TorstenRobitzki/DevPort/hardware/components/Diode_Wurth%20Electronics%20Inc_8240116/eec.models/Wurth_Electronics_Inc_-_8240116.step

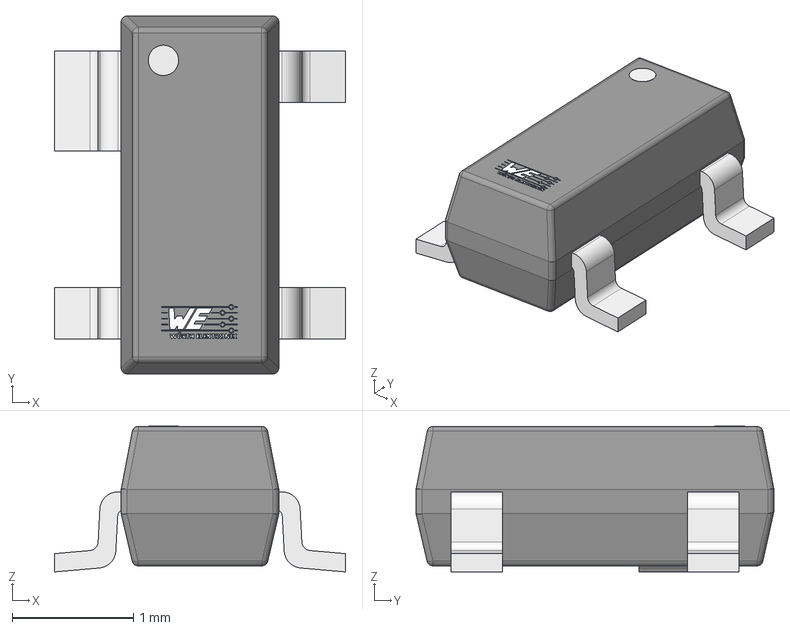
[picture p1: CAD file, 2021-03-17]
hardware/components/Diode_Wurth%20Electronics%20Inc_8240116/eec.models/Wurth_Electronics_Inc_-_8240116.step
2.40 x 2.95 x 1.20 mm
IC_BODY
IC_LEG
circle
IC_LEG_1 x 3
Wurth Electronik
