TorstenRobitzki/DevPort/hardware/components/Trans_On_Semiconductor_MCH3478-TL-H/eec.models/On_Semiconductor_-_MCH3478-TL-H.step

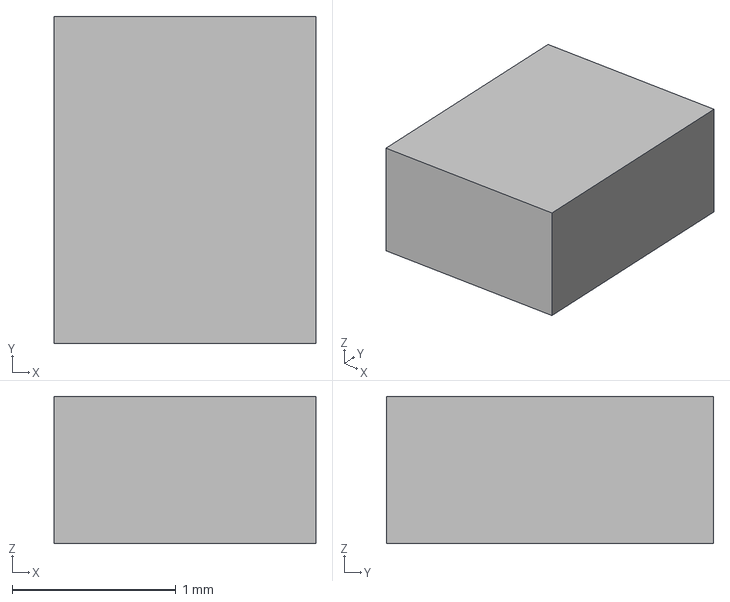
[picture p2: CAD file, 2021-03-17]
hardware/components/Trans_On_Semiconductor_MCH3478-TL-H/eec.models/On_Semiconductor_-_MCH3478-TL-H.step
1.60 x 2.00 x 0.9 mm
