TorstenRobitzki/DevPort/hardware/components/TUSB8041RGCR/TUSB8041RGCR.step

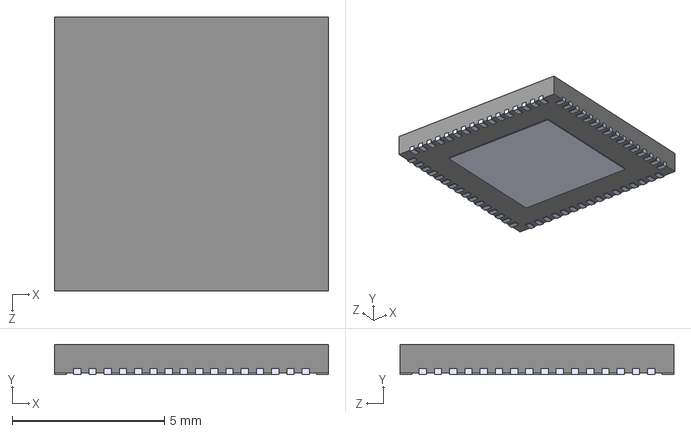
[picture p3: CAD file, 2021-03-17]
hardware/components/TUSB8041RGCR/TUSB8041RGCR.step
9.00 x 1.00 x 9.00 mm
