TorstenRobitzki/DevPort/hardware/lichtleiter.FCStd

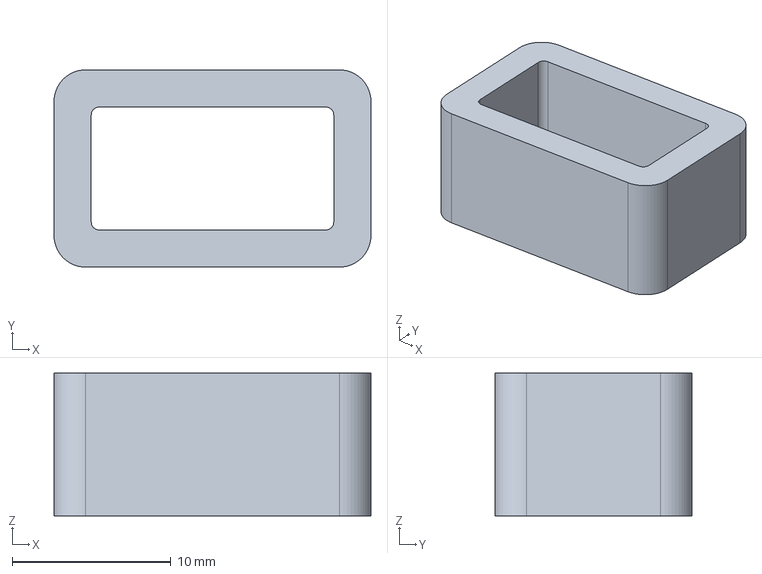
[picture p4: CAD file, 2021-03-17]
hardware/lichtleiter.FCStd
20.0 x 12.4 x 9.00 mm
