TorstenRobitzki/DevPort/hardware/todo.txt

- 1,6mm Platinendicke, wegen USB Stecker
- Passen alle Komponenten am I2C Bus zusammen?
- "It is recommended that only one board ground plane be used in the design." (8041A)
