TorstenRobitzki/DevPort/hardware/base-plane/base-plane.kicad_pcb

## KiCad design hardware/base-plane/base-plane.kicad_pcb (2021-06-17)

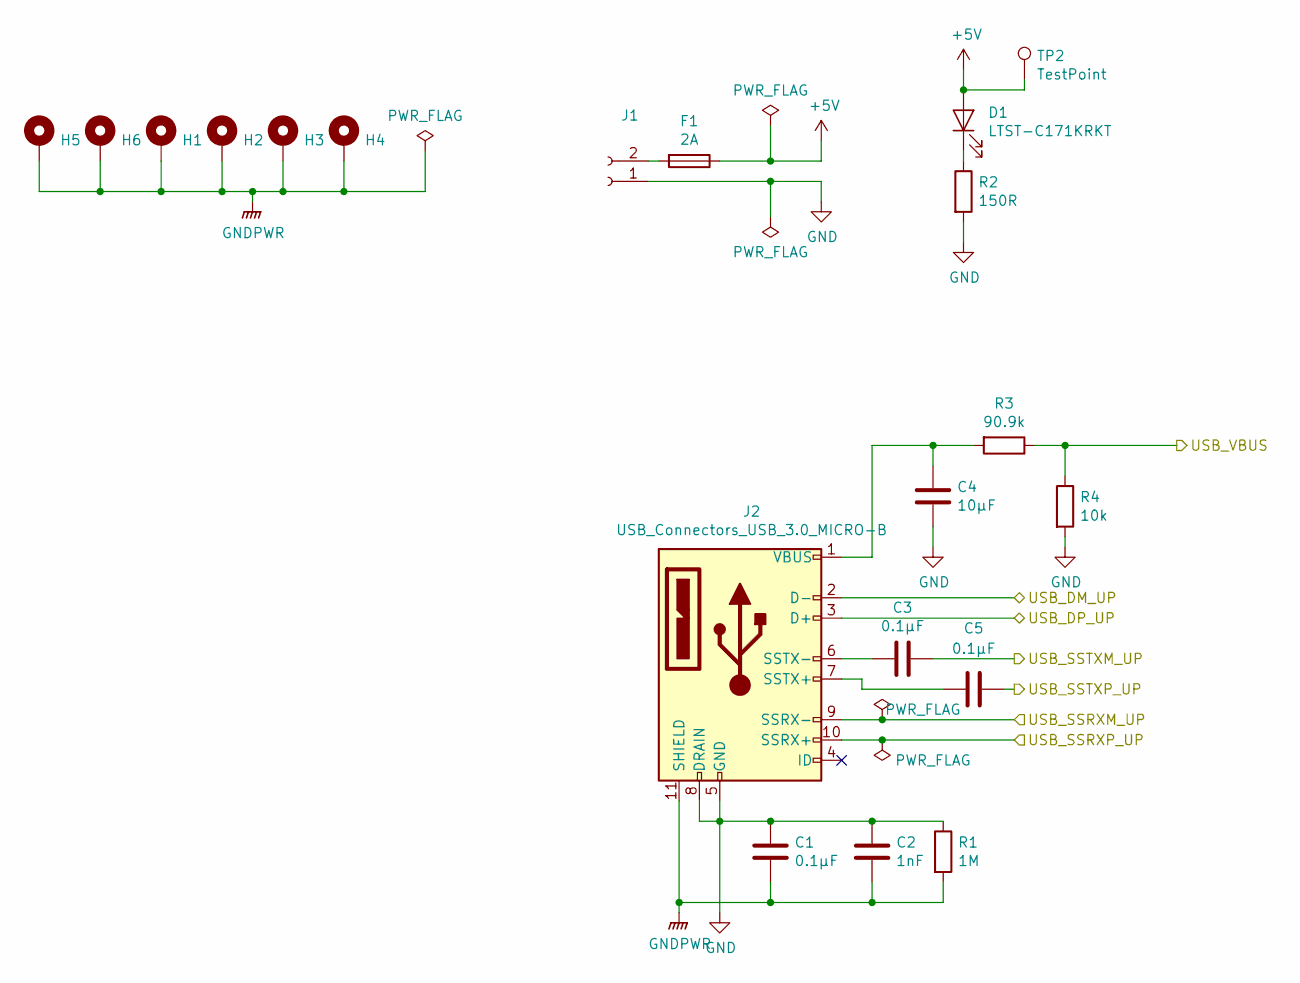
[picture p5: schematic inputs.sch, DevPort Base-Plane]

Parts:
C1, C3, C5: 0.1µF; C_0603_1608Metric
C2: 1nF; C_0603_1608Metric
C4: 10µF; C_0603_1608Metric
D1: LTST-C171KRKT; LED_0805_2012Metric
F1: 2A; Fuse_0603_1608Metric
H1, H2, H3, H4, H5, H6: MountingHole_Pad; MountingHole_3.2mm_M3_Pad_Via
J1: Conn_01x02_Female; Molex_Mini-Fit_Jr_5566-02A_2x01_P4.20mm_Vertical
J2: USB_Connectors_USB_3.0_MICRO-B; 692622420101
R1: 1M; R_0603_1608Metric
R2: 150R; R_0603_1608Metric
R3: 90.9k; R_0603_1608Metric
R4: 10k; R_0603_1608Metric
TP2: TestPoint; TestPoint_THTPad_1.0x1.0mm_Drill0.5mm

Connections:
+5V: D1.2 (A), F1.1, TP2.1; also elsewhere on the board
/hub/USB_DM_UP: J2.2 (D-); also elsewhere on the board
/hub/USB_DP_UP: J2.3 (D+); also elsewhere on the board
/hub/USB_SSRXM_UP: J2.9 (SSRX-); also elsewhere on the board
/hub/USB_SSRXP_UP: J2.10 (SSRX+); also elsewhere on the board
/hub/USB_SSTXM_UP: C3.1; also elsewhere on the board
/hub/USB_SSTXP_UP: C5.1; also elsewhere on the board
/hub/USB_VBUS: R3.1, R4.1; also elsewhere on the board
GND: C1.1, C2.1, C4.1, J1.1, J2.5 (GND), J2.8 (DRAIN), R1.1, R2.2, R4.2; also elsewhere on the board
GNDPWR: C1.2, C2.2, H1.1, H2.1, H3.1, H4.1, H5.1, H6.1, J2.11 (SHIELD), R1.2; also elsewhere on the board
unnamed: C3.2, J2.6 (SSTX-)
unnamed: C4.2, J2.1 (VBUS), R3.2
unnamed: C5.2, J2.7 (SSTX+)
unnamed: D1.1 (K), R2.1
unnamed: F1.2, J1.2

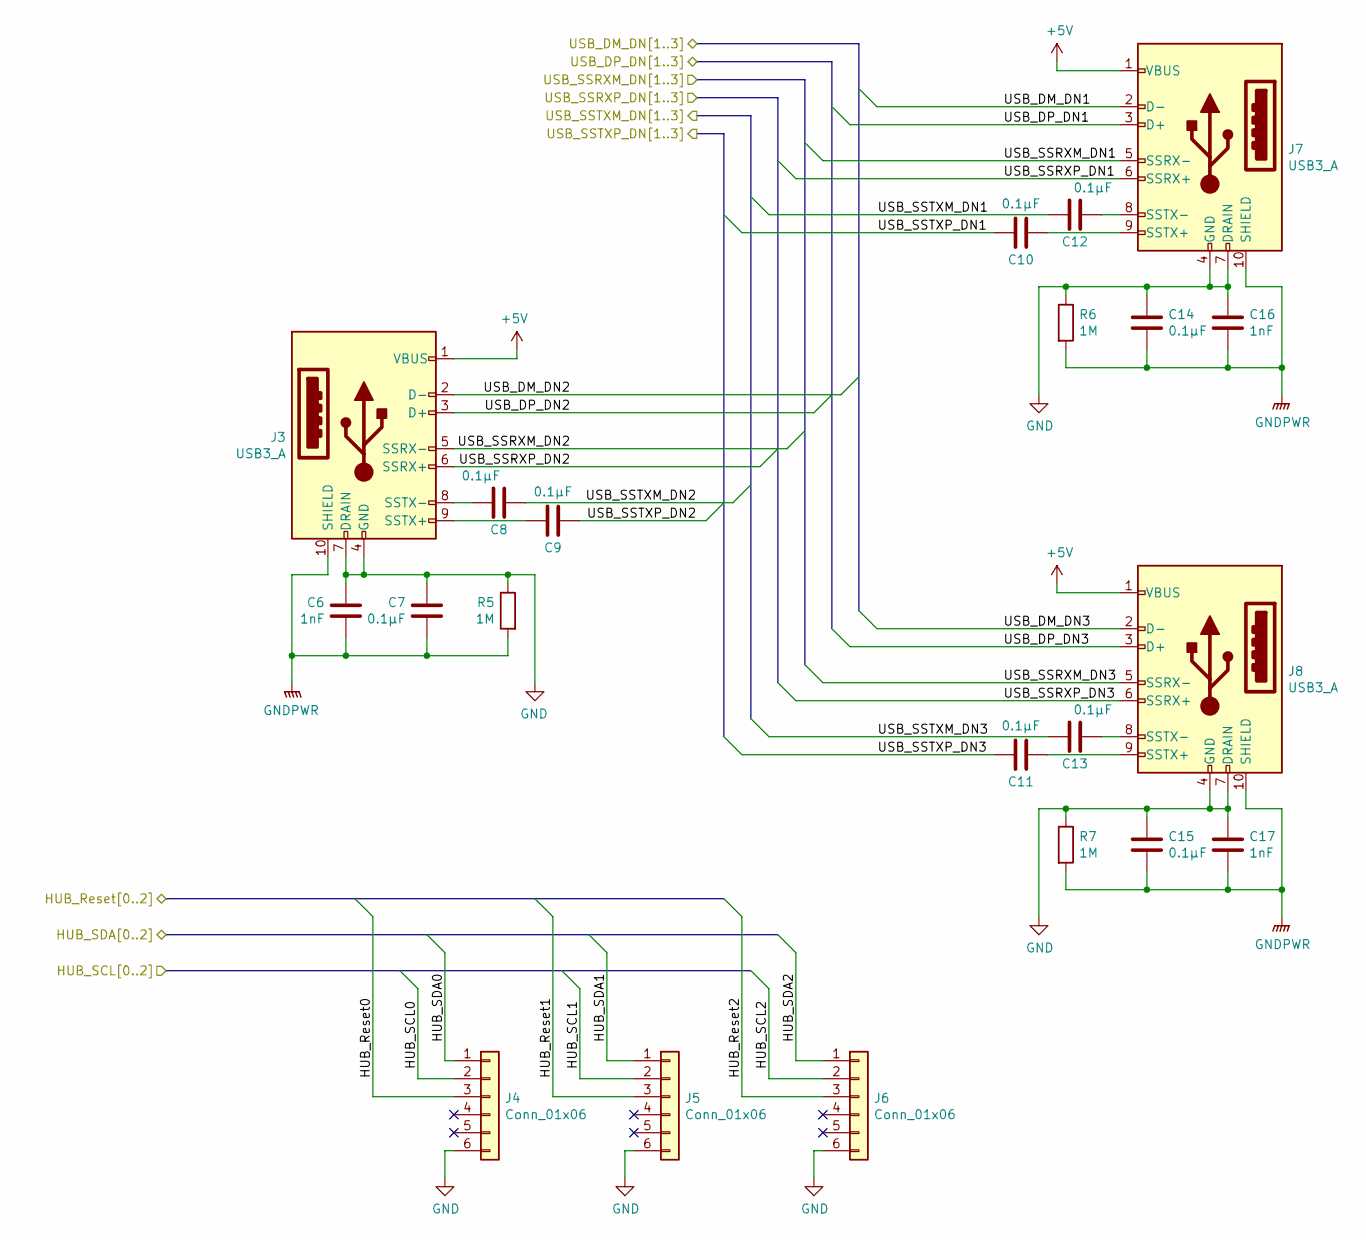
[picture p6: schematic outputs.sch, DevPort Base-Plane]

Parts:
C6, C16, C17: 1nF; C_0603_1608Metric
C7, C8, C9, C10, C11, C12, C13, C14, C15: 0.1µF; C_0603_1608Metric
J3, J7, J8: USB3_A; LUSB-3593-00
J4, J5, J6: Conn_01x06; PinHeader_2x03_P1.27mm_Vertical_SMD
R5, R6, R7: 1M; R_0603_1608Metric

Connections:
+5V: J3.1 (VBUS), J7.1 (VBUS), J8.1 (VBUS); also elsewhere on the board
/controller/HUB_Reset0: J4.3; also elsewhere on the board
/controller/HUB_Reset1: J5.3; also elsewhere on the board
/controller/HUB_Reset2: J6.3; also elsewhere on the board
/controller/HUB_SCL0: J4.2; also elsewhere on the board
/controller/HUB_SCL1: J5.2; also elsewhere on the board
/controller/HUB_SCL2: J6.2; also elsewhere on the board
/controller/HUB_SDA0: J4.1; also elsewhere on the board
/controller/HUB_SDA1: J5.1; also elsewhere on the board
/controller/HUB_SDA2: J6.1; also elsewhere on the board
/hub/USB_DM_DN1: J7.2 (D-); also elsewhere on the board
/hub/USB_DM_DN2: J3.2 (D-); also elsewhere on the board
/hub/USB_DM_DN3: J8.2 (D-); also elsewhere on the board
/hub/USB_DP_DN1: J7.3 (D+); also elsewhere on the board
/hub/USB_DP_DN2: J3.3 (D+); also elsewhere on the board
/hub/USB_DP_DN3: J8.3 (D+); also elsewhere on the board
/hub/USB_SSRXM_DN1: J7.5 (SSRX-); also elsewhere on the board
/hub/USB_SSRXM_DN2: J3.5 (SSRX-); also elsewhere on the board
/hub/USB_SSRXM_DN3: J8.5 (SSRX-); also elsewhere on the board
/hub/USB_SSRXP_DN1: J7.6 (SSRX+); also elsewhere on the board
/hub/USB_SSRXP_DN2: J3.6 (SSRX+); also elsewhere on the board
/hub/USB_SSRXP_DN3: J8.6 (SSRX+); also elsewhere on the board
/hub/USB_SSTXM_DN1: C12.2; also elsewhere on the board
/hub/USB_SSTXM_DN2: C8.2; also elsewhere on the board
/hub/USB_SSTXM_DN3: C13.2; also elsewhere on the board
/hub/USB_SSTXP_DN1: C10.2; also elsewhere on the board
/hub/USB_SSTXP_DN2: C9.2; also elsewhere on the board
/hub/USB_SSTXP_DN3: C11.2; also elsewhere on the board
GND: C6.1, C7.1, C14.1, C15.1, C16.1, C17.1, J3.4 (GND), J3.7 (DRAIN), J4.6, J5.6, J6.6, J7.4 (GND), J7.7 (DRAIN), J8.4 (GND), J8.7 (DRAIN), R5.1, R6.1, R7.1; also elsewhere on the board
GNDPWR: C6.2, C7.2, C14.2, C15.2, C16.2, C17.2, J3.10 (SHIELD), J7.10 (SHIELD), J8.10 (SHIELD), R5.2, R6.2, R7.2; also elsewhere on the board
unnamed: C8.1, J3.8 (SSTX-)
unnamed: C9.1, J3.9 (SSTX+)
unnamed: C10.1, J7.9 (SSTX+)
unnamed: C11.1, J8.9 (SSTX+)
unnamed: C12.1, J7.8 (SSTX-)
unnamed: C13.1, J8.8 (SSTX-)

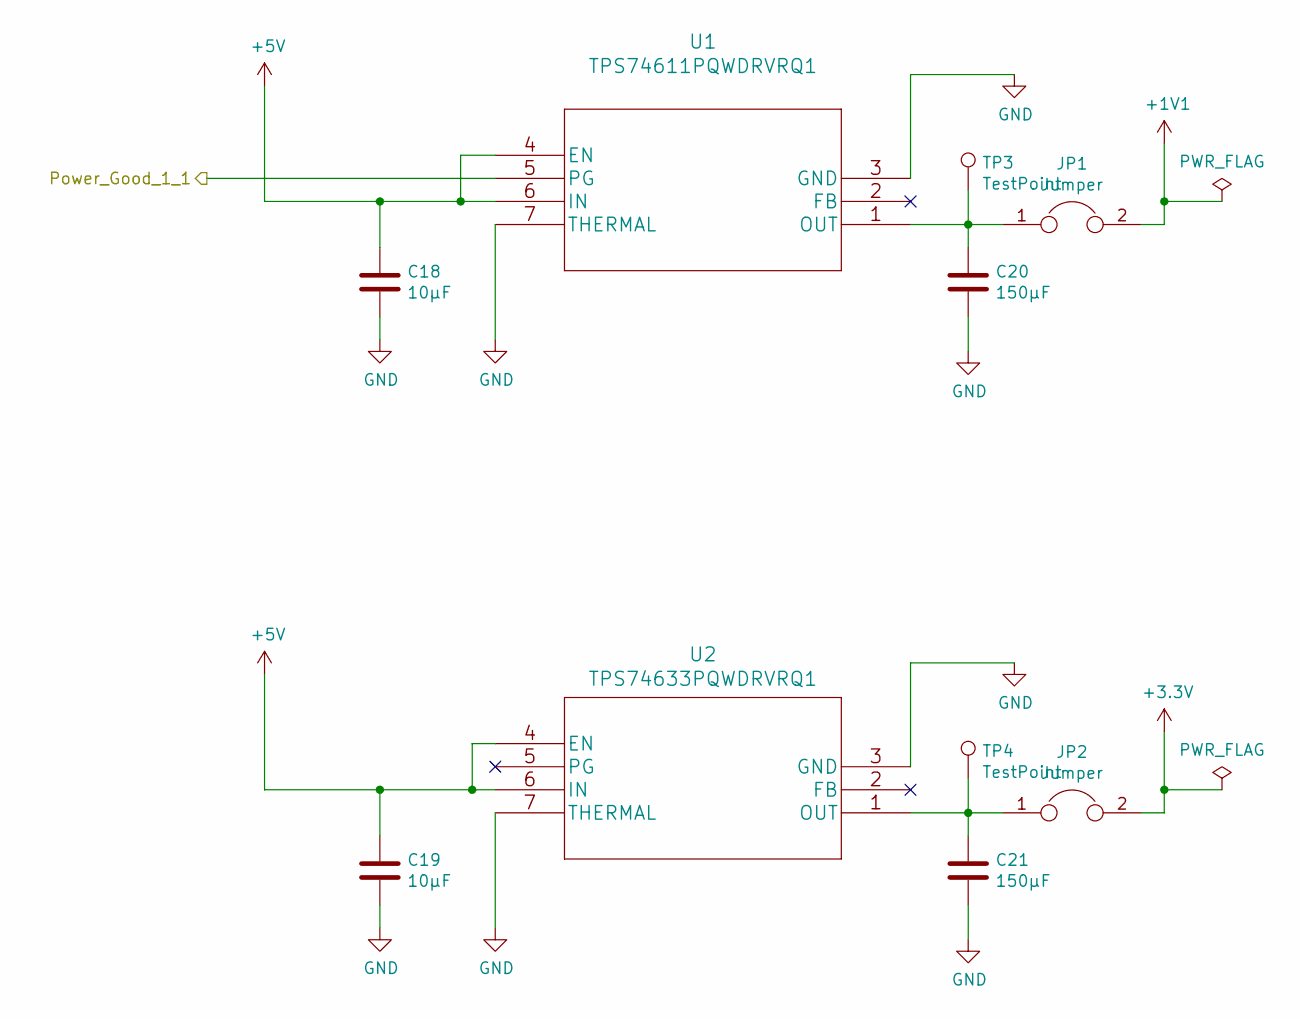
[picture p7: schematic power.sch, DevPort Base-Plane]

Parts:
C18, C19: 10µF; C_0603_1608Metric
C20, C21: 150µF; C_1210_3225Metric
JP1, JP2: Jumper; SolderJumper-2_P1.3mm_Bridged_RoundedPad1.0x1.5mm
TP3, TP4: TestPoint; TestPoint_THTPad_1.0x1.0mm_Drill0.5mm
U1: TPS74611PQWDRVRQ1; TPS74601PBQWDRVRQ1
U2: TPS74633PQWDRVRQ1; TPS74601PBQWDRVRQ1

Connections:
+1V1: JP1.2; also elsewhere on the board
+5V: C18.1, C19.1, U1.4 (EN), U1.6 (IN), U2.4 (EN), U2.6 (IN); also elsewhere on the board
/controller/Power_Good_1_1: U1.5 (PG); also elsewhere on the board
GND: C18.2, C19.2, C20.2, C21.2, U1.3 (GND), U1.7 (THERMAL), U2.3 (GND), U2.7 (THERMAL); also elsewhere on the board
unnamed: C20.1, JP1.1, TP3.1, U1.1 (OUT)
unnamed: C21.1, JP2.1, TP4.1, U2.1 (OUT)

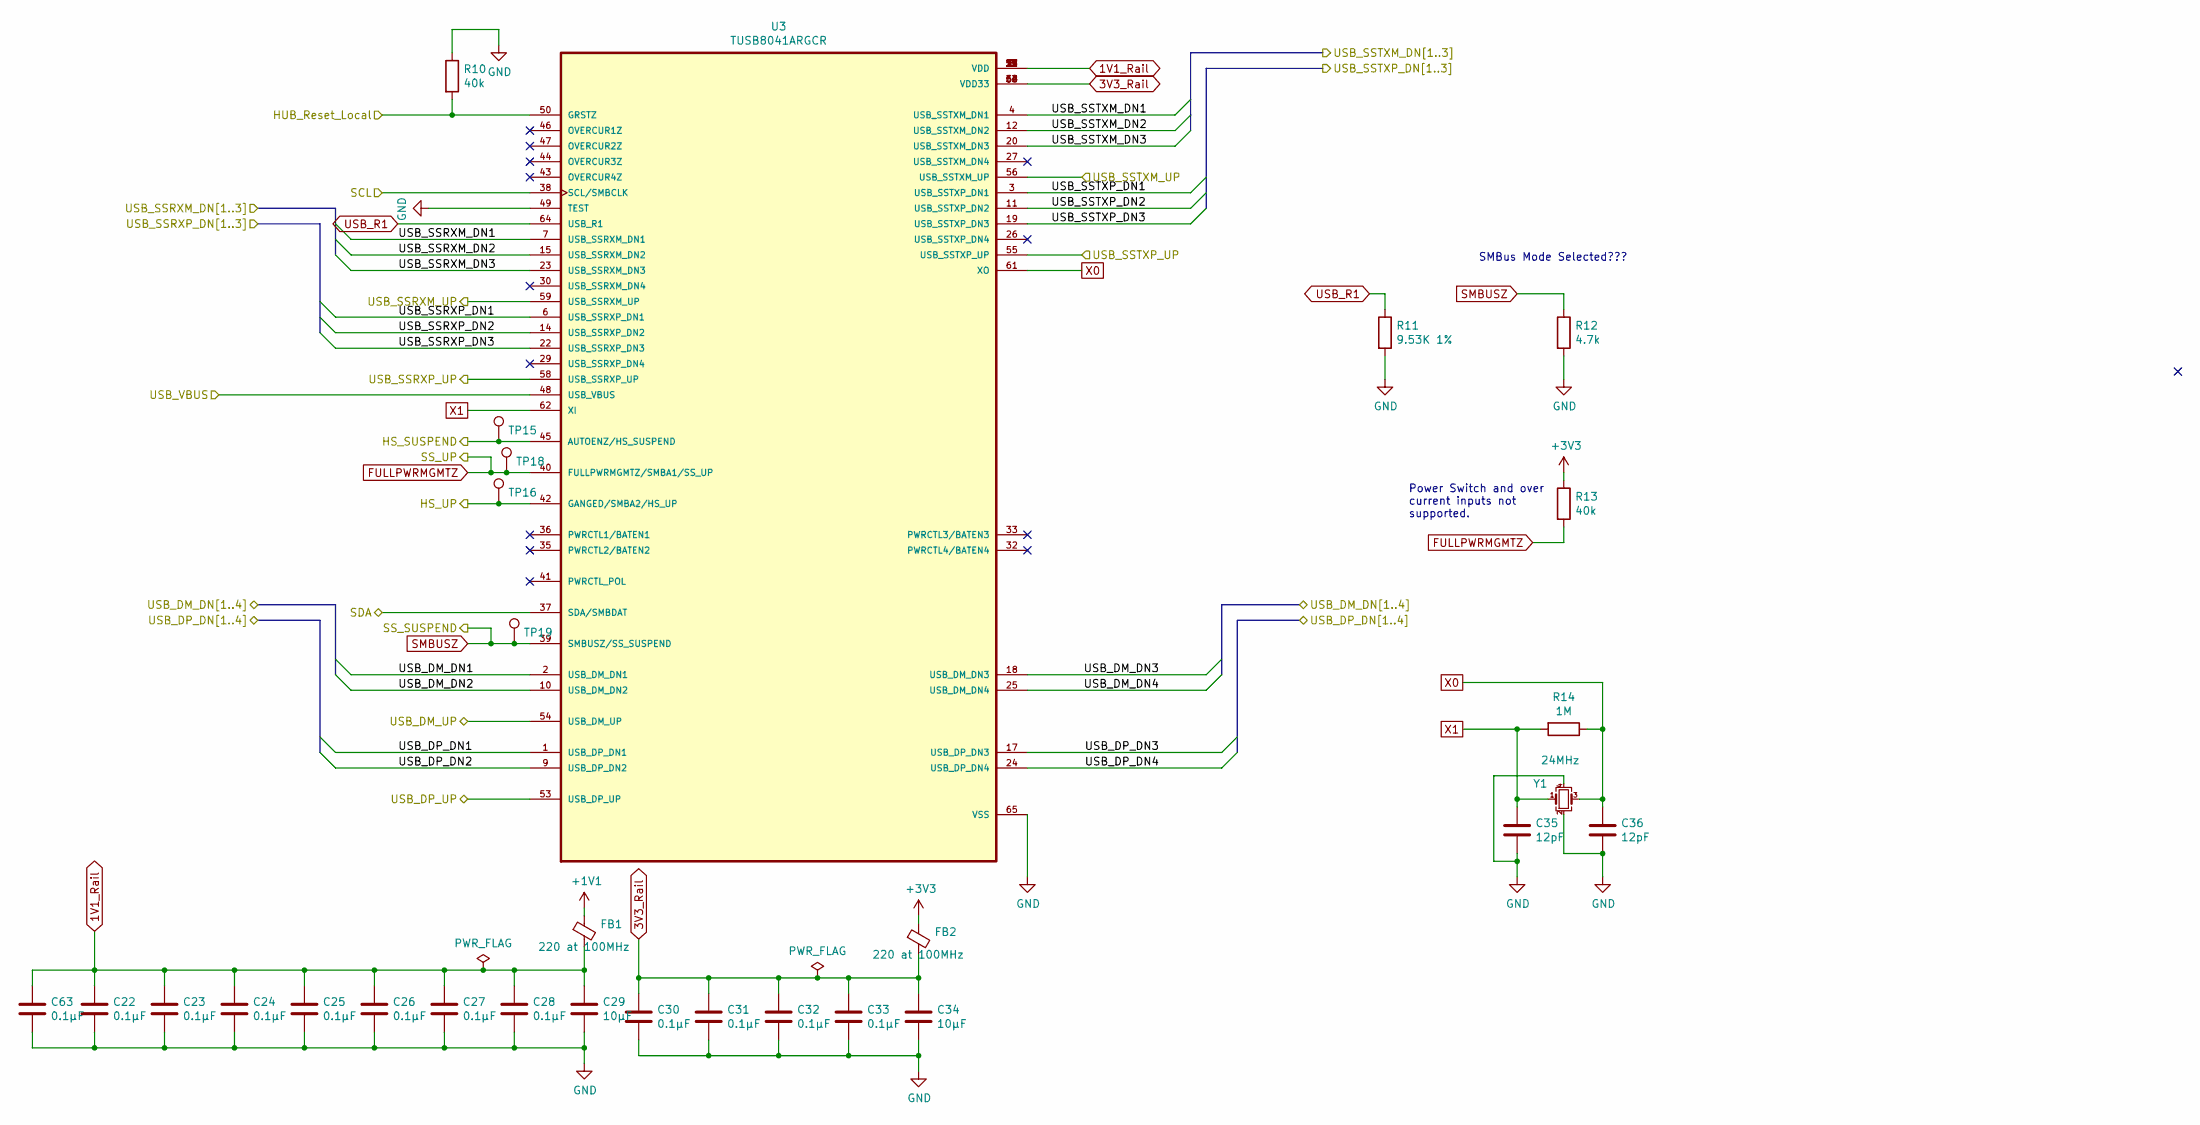
[picture p8: schematic hub.sch, DevPort Base-Plane]

Parts:
C22, C23, C24, C25, C26, C27, C28, C30, C31, C32, C33, C63: 0.1µF; C_0603_1608Metric
C29, C34: 10µF; C_0603_1608Metric
C35, C36: 12pF; C_0603_1608Metric
FB1, FB2: 220 at 100MHz; L_0603_1608Metric
R10, R13: 40k; R_0603_1608Metric
R11: 9.53K 1%; R_0603_1608Metric
R12: 4.7k; R_0603_1608Metric
R14: 1M; R_0603_1608Metric
TP15, TP16, TP18, TP19: TestPoint; TestPoint_THTPad_1.0x1.0mm_Drill0.5mm
U3: TUSB8041ARGCR; QFN50P900X900X100-65N
Y1: 24MHz; Crystal_SMD_3225-4Pin_3.2x2.5mm

Connections:
1V1_Rail: C22.1, C23.1, C24.1, C25.1, C26.1, C27.1, C28.1, C29.1, C63.1, FB1.2, U3.5 (VDD), U3.8 (VDD), U3.13 (VDD), U3.21 (VDD), U3.28 (VDD), U3.31 (VDD), U3.51 (VDD), U3.57 (VDD)
3V3_Rail: C30.1, C31.1, C32.1, C33.1, C34.1, FB2.2, U3.16 (VDD33), U3.34 (VDD33), U3.52 (VDD33), U3.63 (VDD33)
+1V1: FB1.1; also elsewhere on the board
/hub/USB_DM_DN1: U3.2 (USB_DM_DN1); also elsewhere on the board
/hub/USB_DM_DN2: U3.10 (USB_DM_DN2); also elsewhere on the board
/hub/USB_DM_DN3: U3.18 (USB_DM_DN3); also elsewhere on the board
/hub/USB_DM_UP: U3.54 (USB_DM_UP); also elsewhere on the board
/hub/USB_DP_DN1: U3.1 (USB_DP_DN1); also elsewhere on the board
/hub/USB_DP_DN2: U3.9 (USB_DP_DN2); also elsewhere on the board
/hub/USB_DP_DN3: U3.17 (USB_DP_DN3); also elsewhere on the board
/hub/USB_DP_UP: U3.53 (USB_DP_UP); also elsewhere on the board
/hub/USB_SSRXM_DN1: U3.7 (USB_SSRXM_DN1); also elsewhere on the board
/hub/USB_SSRXM_DN2: U3.15 (USB_SSRXM_DN2); also elsewhere on the board
/hub/USB_SSRXM_DN3: U3.23 (USB_SSRXM_DN3); also elsewhere on the board
/hub/USB_SSRXM_UP: U3.59 (USB_SSRXM_UP); also elsewhere on the board
/hub/USB_SSRXP_DN1: U3.6 (USB_SSRXP_DN1); also elsewhere on the board
/hub/USB_SSRXP_DN2: U3.14 (USB_SSRXP_DN2); also elsewhere on the board
/hub/USB_SSRXP_DN3: U3.22 (USB_SSRXP_DN3); also elsewhere on the board
/hub/USB_SSRXP_UP: U3.58 (USB_SSRXP_UP); also elsewhere on the board
/hub/USB_SSTXM_DN1: U3.4 (USB_SSTXM_DN1); also elsewhere on the board
/hub/USB_SSTXM_DN2: U3.12 (USB_SSTXM_DN2); also elsewhere on the board
/hub/USB_SSTXM_DN3: U3.20 (USB_SSTXM_DN3); also elsewhere on the board
/hub/USB_SSTXM_UP: U3.56 (USB_SSTXM_UP); also elsewhere on the board
/hub/USB_SSTXP_DN1: U3.3 (USB_SSTXP_DN1); also elsewhere on the board
/hub/USB_SSTXP_DN2: U3.11 (USB_SSTXP_DN2); also elsewhere on the board
/hub/USB_SSTXP_DN3: U3.19 (USB_SSTXP_DN3); also elsewhere on the board
/hub/USB_SSTXP_UP: U3.55 (USB_SSTXP_UP); also elsewhere on the board
FULLPWRMGMTZ: R13.2, TP18.1, U3.40 (FULLPWRMGMTZ/SMBA1/SS_UP); also elsewhere on the board
GND: C22.2, C23.2, C24.2, C25.2, C26.2, C27.2, C28.2, C29.2, C30.2, C31.2, C32.2, C33.2, C34.2, C35.2, C36.2, C63.2, R10.1, R11.2, R12.2, U3.49 (TEST), U3.65 (VSS), Y1.2, Y1.4; also elsewhere on the board
HS_SUSPEND: TP15.1, U3.45 (AUTOENZ/HS_SUSPEND); also elsewhere on the board
HS_UP: TP16.1, U3.42 (GANGED/SMBA2/HS_UP); also elsewhere on the board
HUB_Reset_Local: R10.2, U3.50 (GRSTZ); also elsewhere on the board
unnamed 105: U3.48 (USB_VBUS); also elsewhere on the board
SCL: U3.38 (SCL/SMBCLK); also elsewhere on the board
SDA: U3.37 (SDA/SMBDAT); also elsewhere on the board
SMBUSZ: R12.1, TP19.1, U3.39 (SMBUSZ/SS_SUSPEND); also elsewhere on the board
USB_DM_DN4: U3.25 (USB_DM_DN4); also elsewhere on the board
USB_DP_DN4: U3.24 (USB_DP_DN4); also elsewhere on the board
USB_R1: R11.1, U3.64 (USB_R1)
X0: C36.1, R14.1, U3.61 (XO), Y1.3
X1: C35.1, R14.2, U3.62 (XI), Y1.1

Notes on the sheet:
SMBus Mode Selected???
Power Switch and over current inputs not supported.

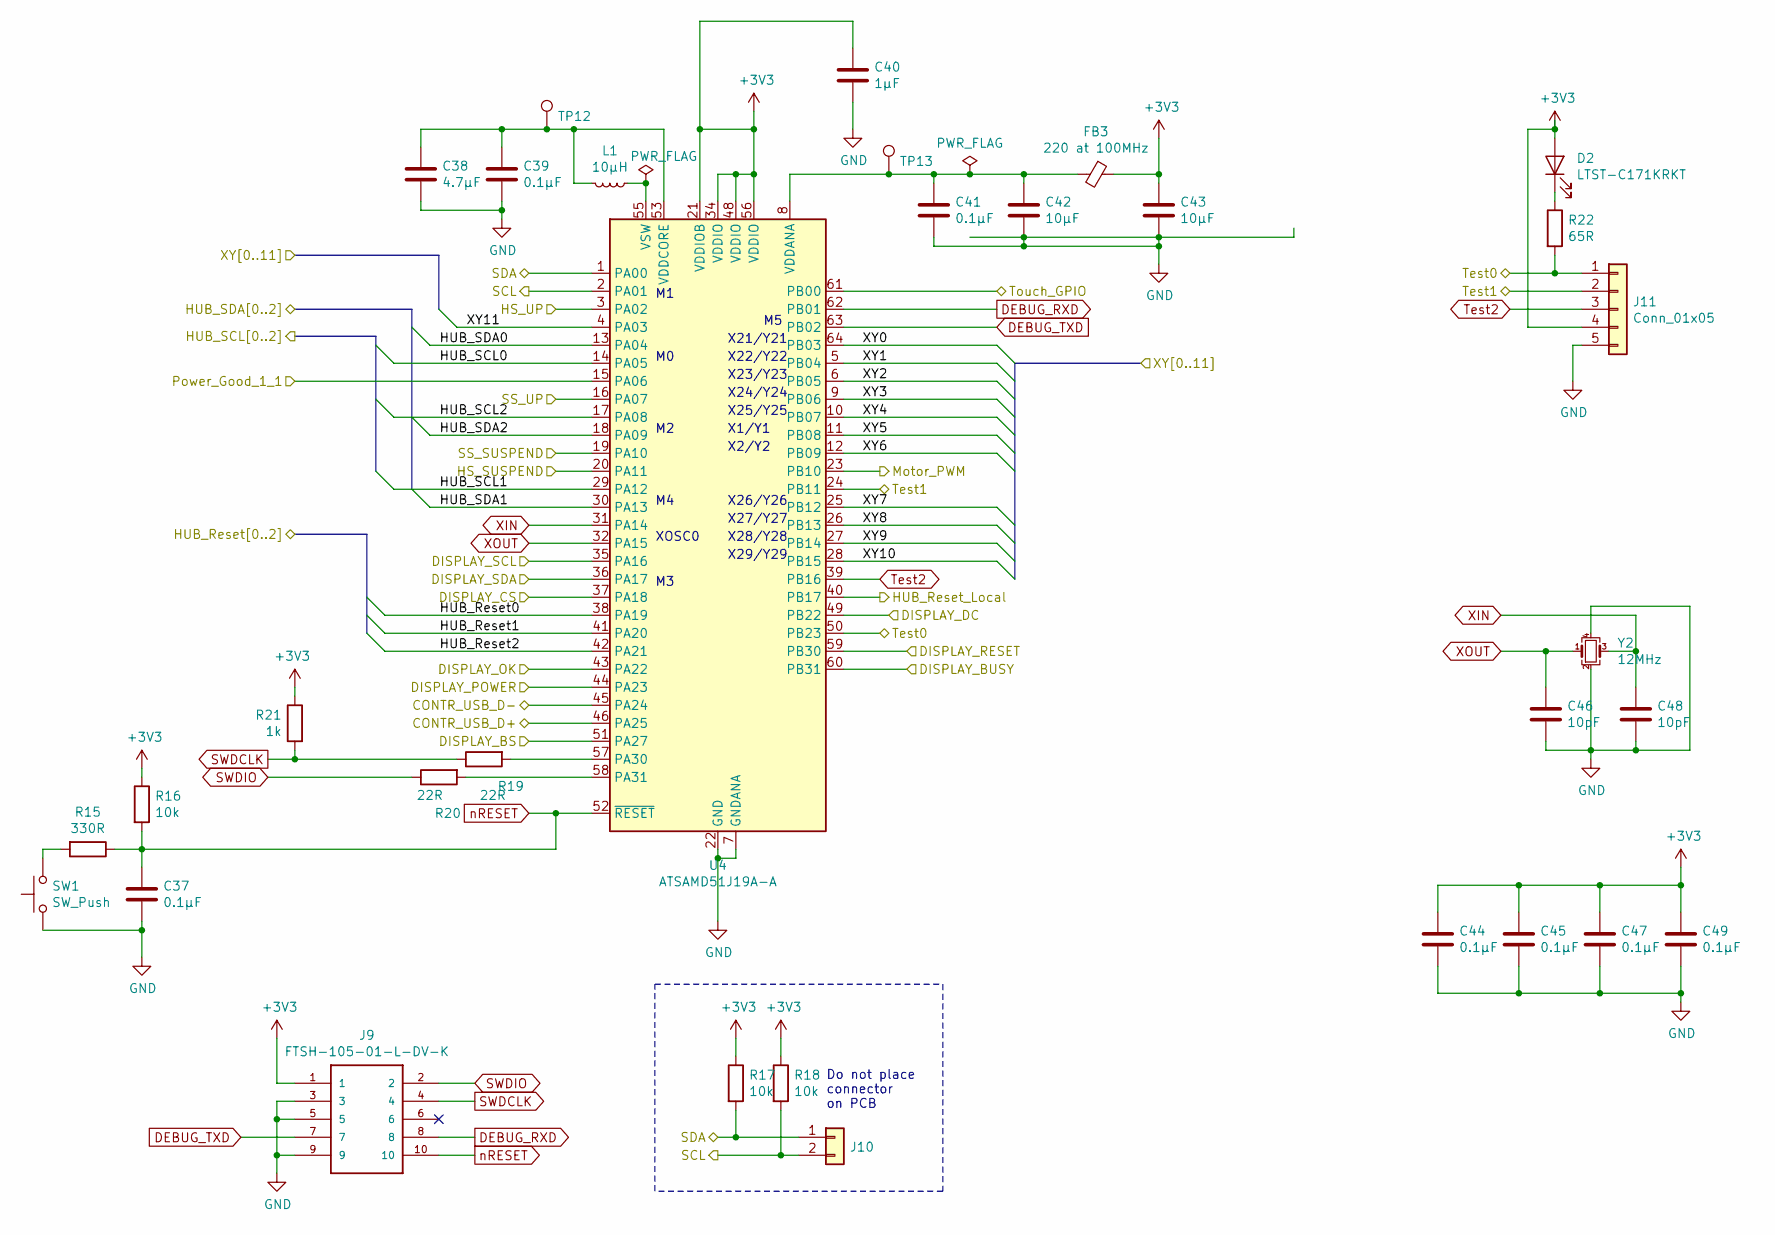
[picture p9: schematic controller.sch, DevPort Base-Plane]

Parts:
C37, C39, C41, C44, C45, C47, C49: 0.1µF; C_0603_1608Metric
C38: 4.7µF; C_0603_1608Metric
C40: 1µF; C_0603_1608Metric
C42, C43: 10µF; C_0603_1608Metric
C46, C48: 10pF; C_0603_1608Metric
D2: LTST-C171KRKT; LED_0805_2012Metric
FB3: 220 at 100MHz; L_0603_1608Metric
J9: FTSH-105-01-L-DV-K; SAMTEC_FTSH-105-XX-X-DV
J10: Conn_01x02; PinHeader_1x02_P2.54mm_Vertical
J11: Conn_01x05; PinHeader_1x05_P2.54mm_Vertical
L1: 10µH; IND_LQH32PZ100MNCL
R15: 330R; R_0603_1608Metric
R16, R17, R18: 10k; R_0603_1608Metric
R19, R20: 22R; R_0603_1608Metric
R21: 1k; R_0603_1608Metric
R22: 65R; R_0603_1608Metric
SW1: SW_Push; Panasonic_EVQPUJ_EVQPUA
TP12, TP13: TestPoint; TestPoint_THTPad_1.0x1.0mm_Drill0.5mm
U4: ATSAMD51J19A-A; TQFP-64_10x10mm_P0.5mm
Y2: 12MHz; Crystal_SMD_2520-4Pin_2.5x2.0mm

Connections:
/controller/DISPLAY_BS: U4.51 (PA27); also elsewhere on the board
/controller/DISPLAY_CS: U4.37 (PA18); also elsewhere on the board
/controller/DISPLAY_DC: U4.49 (PB22); also elsewhere on the board
/controller/DISPLAY_OK: U4.43 (PA22); also elsewhere on the board
/controller/DISPLAY_POWER: U4.44 (PA23); also elsewhere on the board
/controller/DISPLAY_SCL: U4.35 (PA16); also elsewhere on the board
/controller/DISPLAY_SDA: U4.36 (PA17); also elsewhere on the board
/controller/HUB_Reset0: U4.38 (PA19); also elsewhere on the board
/controller/HUB_Reset1: U4.41 (PA20); also elsewhere on the board
/controller/HUB_Reset2: U4.42 (PA21); also elsewhere on the board
/controller/HUB_SCL0: U4.14 (PA05); also elsewhere on the board
/controller/HUB_SCL1: U4.29 (PA12); also elsewhere on the board
/controller/HUB_SCL2: U4.17 (PA08); also elsewhere on the board
/controller/HUB_SDA0: U4.13 (PA04); also elsewhere on the board
/controller/HUB_SDA1: U4.30 (PA13); also elsewhere on the board
/controller/HUB_SDA2: U4.18 (PA09); also elsewhere on the board
/controller/Motor_PWM: U4.23 (PB10); also elsewhere on the board
/controller/Power_Good_1_1: U4.15 (PA06); also elsewhere on the board
/controller/Test0: J11.1, R22.2, U4.50 (PB23); also elsewhere on the board
/controller/Test1: J11.2, U4.24 (PB11)
/controller/Touch_GPIO: U4.61 (PB00); also elsewhere on the board
/controller/XY0: U4.64 (PB03); also elsewhere on the board
/controller/XY1: U4.5 (PB04); also elsewhere on the board
/controller/XY2: U4.6 (PB05); also elsewhere on the board
/controller/XY3: U4.9 (PB06); also elsewhere on the board
/controller/XY4: U4.10 (PB07); also elsewhere on the board
/controller/XY5: U4.11 (PB08); also elsewhere on the board
/controller/XY6: U4.12 (PB09); also elsewhere on the board
/controller/XY7: U4.25 (PB12); also elsewhere on the board
/controller/XY8: U4.26 (PB13); also elsewhere on the board
/controller/XY9: U4.27 (PB14); also elsewhere on the board
/controller/XY10: U4.28 (PB15); also elsewhere on the board
/controller/XY11: U4.4 (PA03); also elsewhere on the board
DEBUG_RXD: J9.8, U4.62 (PB01)
DEBUG_TXD: J9.7, U4.63 (PB02)
FULLPWRMGMTZ: U4.16 (PA07); also elsewhere on the board
GND: C37.2, C38.2, C39.2, C40.2, C41.2, C42.2, C43.2, C44.2, C45.2, C46.2, C47.2, C48.2, C49.2, J9.3, J9.5, J9.9, J11.5, SW1.1, U4.7 (GNDANA), U4.22 (GND), U4.33 (GND), U4.47 (GND), U4.54 (GND), Y2.2, Y2.4; also elsewhere on the board
HS_SUSPEND: U4.20 (PA11); also elsewhere on the board
HS_UP: U4.3 (PA02); also elsewhere on the board
HUB_Reset_Local: U4.40 (PB17); also elsewhere on the board
unnamed: C38.1, C39.1, L1.2, TP12.1, U4.53 (VDDCORE)
unnamed: C41.1, C42.1, FB3.2, TP13.1, U4.8 (VDDANA)
unnamed: D2.1 (K), R22.1
unnamed: L1.1, U4.55 (VSW)
unnamed: R15.2, SW1.2
SCL: J10.2, R18.2, U4.2 (PA01); also elsewhere on the board
SDA: J10.1, R17.2, U4.1 (PA00); also elsewhere on the board
SMBUSZ: U4.19 (PA10); also elsewhere on the board
SWDCLK: J9.4, R19.1, R21.2
SWDIO: J9.2, R20.1
Test2: J11.3, U4.39 (PB16)
USB_DM_DN4: U4.45 (PA24); also elsewhere on the board
USB_DP_DN4: U4.46 (PA25); also elsewhere on the board
XIN: C48.1, U4.31 (PA14), Y2.3
XOUT: C46.1, U4.32 (PA15), Y2.1
nRESET: C37.1, J9.10, R15.1, R16.2, U4.52 (~RESET)

Notes on the sheet:
XOSC0
X25/Y25
X1/Y1
X2/Y2
X26/Y26
X27/Y27
X28/Y28
X29/Y29
Do not place connector on PCB
X24/Y24
X23/Y23
X22/Y22
X21/Y21

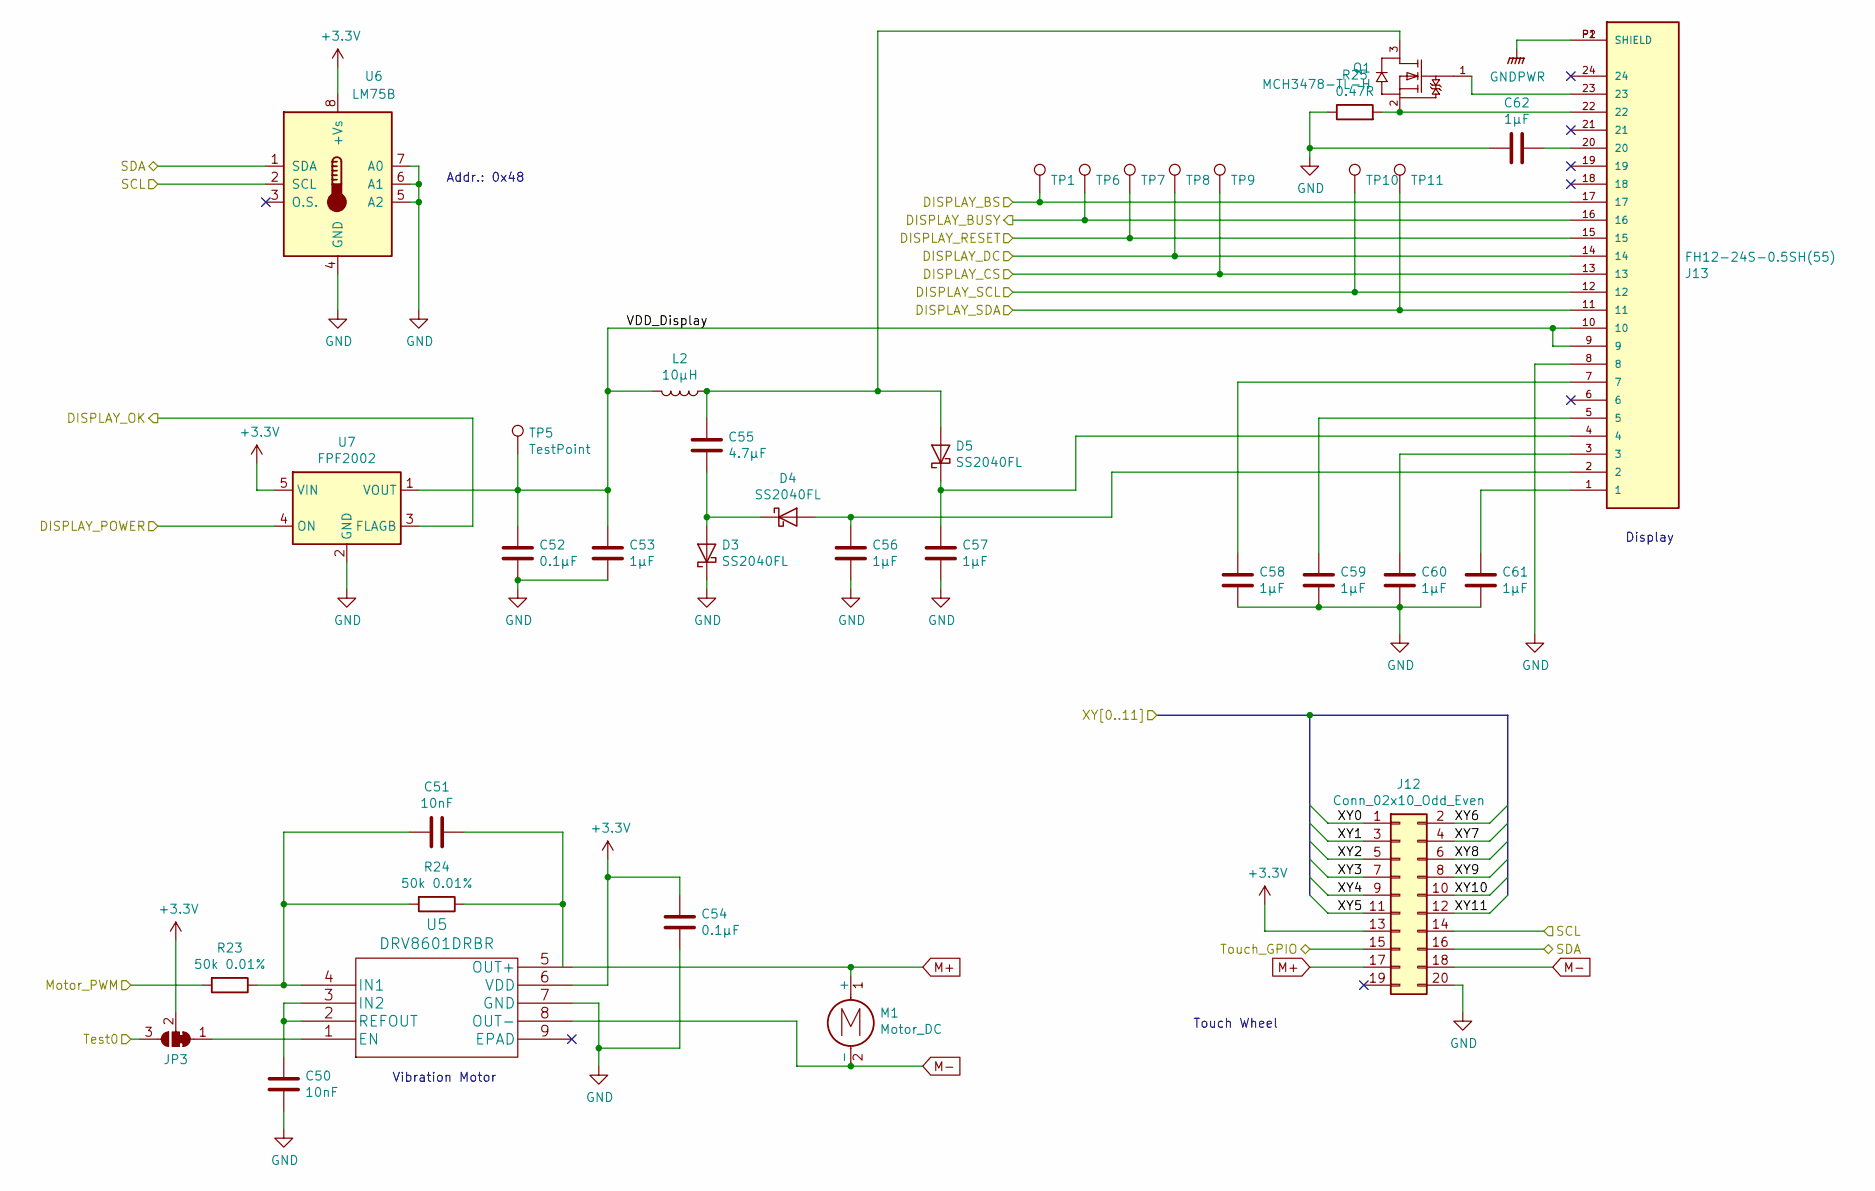
[picture p10: schematic user_interface.sch, DevPort Base-Plane]

Parts:
C50, C51: 10nF; C_0603_1608Metric
C52, C54: 0.1µF; C_0603_1608Metric
C53, C56, C57, C58, C59, C60, C61, C62: 1µF; C_0603_1608Metric
C55: 4.7µF; C_0603_1608Metric
D3, D4, D5: SS2040FL; D_SOD-123F
J12: Conn_02x10_Odd_Even; Molex_SlimStack_55560-0201_2x10_P0.50mm_Vertical
J13: FH12-24S-0.5SH(55); HRS_FH12-24S-0.5SH(55)
JP3: SolderJumper_3_Bridged12; SolderJumper-3_P1.3mm_Bridged12_RoundedPad1.0x1.5mm
L2: 10µH; IND_LQH32PZ100MNCL
M1: Motor_DC; PinHeader_1x02_P2.54mm_Vertical
Q1: MCH3478-TL-H; On_Semiconductor-MCH3478-TL-H-Manufacturer_Recommended
R23, R24: 50k 0.01%; R_0603_1608Metric
R25: 0.47R; R_0603_1608Metric
TP1, TP5, TP6, TP7, TP8, TP9, TP10, TP11: TestPoint; TestPoint_THTPad_1.0x1.0mm_Drill0.5mm
U5: DRV8601DRBR
U6: LM75B; TSSOP-8_3x3mm_P0.65mm
U7: FPF2002; SOT-353_SC-70-5

Connections:
/controller/DISPLAY_BS: J13.17, TP1.1; also elsewhere on the board
/controller/DISPLAY_CS: J13.13, TP9.1; also elsewhere on the board
/controller/DISPLAY_DC: J13.14, TP8.1; also elsewhere on the board
/controller/DISPLAY_OK: U7.3 (FLAGB); also elsewhere on the board
/controller/DISPLAY_POWER: U7.4 (ON); also elsewhere on the board
/controller/DISPLAY_SCL: J13.12, TP10.1; also elsewhere on the board
/controller/DISPLAY_SDA: J13.11, TP11.1; also elsewhere on the board
/controller/Motor_PWM: R23.2; also elsewhere on the board
/controller/Test0: JP3.3 (B); also elsewhere on the board
/controller/Touch_GPIO: J12.15; also elsewhere on the board
/controller/XY0: J12.1; also elsewhere on the board
/controller/XY1: J12.3; also elsewhere on the board
/controller/XY2: J12.5; also elsewhere on the board
/controller/XY3: J12.7; also elsewhere on the board
/controller/XY4: J12.9; also elsewhere on the board
/controller/XY5: J12.11; also elsewhere on the board
/controller/XY6: J12.2; also elsewhere on the board
/controller/XY7: J12.4; also elsewhere on the board
/controller/XY8: J12.6; also elsewhere on the board
/controller/XY9: J12.8; also elsewhere on the board
/controller/XY10: J12.10; also elsewhere on the board
/controller/XY11: J12.12; also elsewhere on the board
/user_interface/VDD_Display: C52.1, C53.1, J13.9, J13.10, L2.2, TP5.1, U7.1 (VOUT)
GND: C50.2, C52.2, C53.2, C54.2, C56.2, C57.2, C58.1, C59.1, C60.2, C61.2, C62.2, D3.1 (K), J12.20, J13.8, R25.1, U5.7 (GND), U6.4 (GND), U6.5 (A2), U6.6 (A1), U6.7 (A0), U7.2 (GND); also elsewhere on the board
GNDPWR: J13.P1 (SHIELD), J13.P2 (SHIELD); also elsewhere on the board
M+: J12.17, M1.1 (+), U5.5 (OUT+)
M-: J12.18, M1.2 (-), U5.8 (OUT-)
unnamed: C50.1, U5.2 (REFOUT), U5.3 (IN2)
unnamed: C51.1, R24.1
unnamed: C51.2, R23.1, R24.2, U5.4 (IN1)
unnamed: C55.1, D5.2 (A), L2.1, Q1.3 (D)
unnamed: C55.2, D3.2 (A), D4.1 (K)
unnamed: C56.1, D4.2 (A), J13.2
unnamed: C57.1, D5.1 (K), J13.4
unnamed: C58.2, J13.7
unnamed: C59.2, J13.5
unnamed: C60.1, J13.3
unnamed: C61.1, J13.1
unnamed: C62.1, J13.20
unnamed: J13.22, Q1.2 (S), R25.2
unnamed: J13.23, Q1.1 (G)
unnamed: JP3.1 (A), U5.1 (EN)
SCL: J12.14, U6.2 (SCL); also elsewhere on the board
SDA: J12.16, U6.1 (SDA); also elsewhere on the board

Notes on the sheet:
Display
Touch Wheel
Addr.: 0x48
Vibration Motor

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
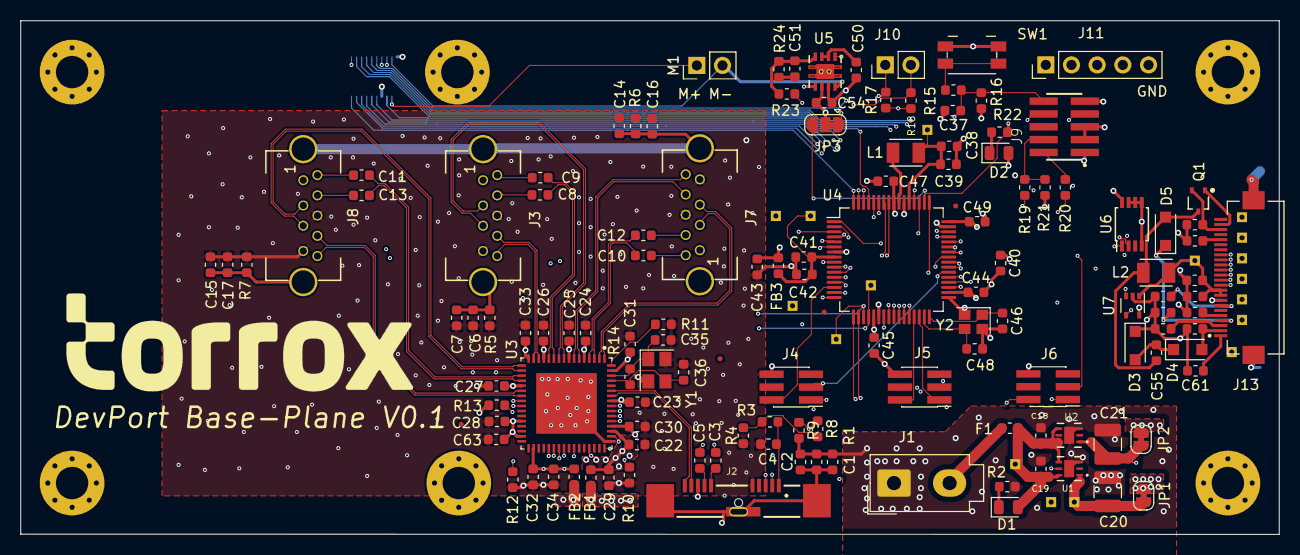
[picture p11: board base-plane.kicad_pcb from above]

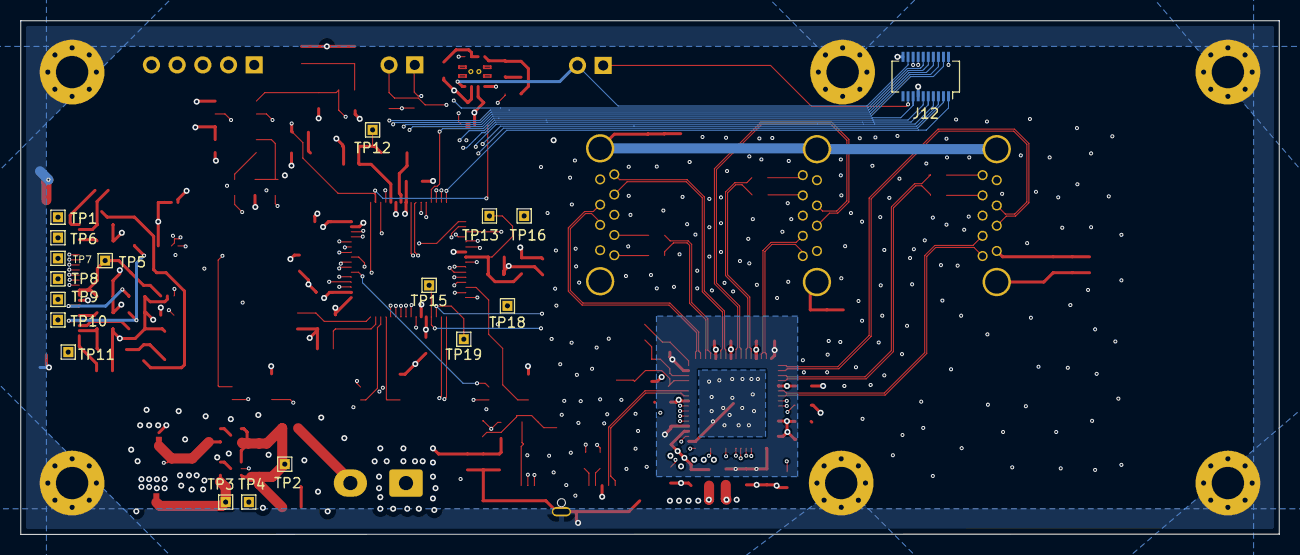
[picture p12: board base-plane.kicad_pcb from below]

Board: 6 copper layers, 124.5 x 50.8 mm, 150 parts (18 on the bottom side), 126 nets.

Other parts of the board:
R8: 90.9k 1%; R_0603_1608Metric
R9: 10k 1%; R_0603_1608Metric

Their connections:
/hub/USB_VBUS: R8.2; also elsewhere on the board
GND: R9.2; also elsewhere on the board
unnamed 105: R8.1, R9.1; also elsewhere on the board
