TorstenRobitzki/DevPort/hardware/touch-pannel/touch-pannel/touch-pannel.kicad_pcb

## KiCad design hardware/touch-pannel/touch-pannel/touch-pannel.kicad_pcb (2021-03-17)

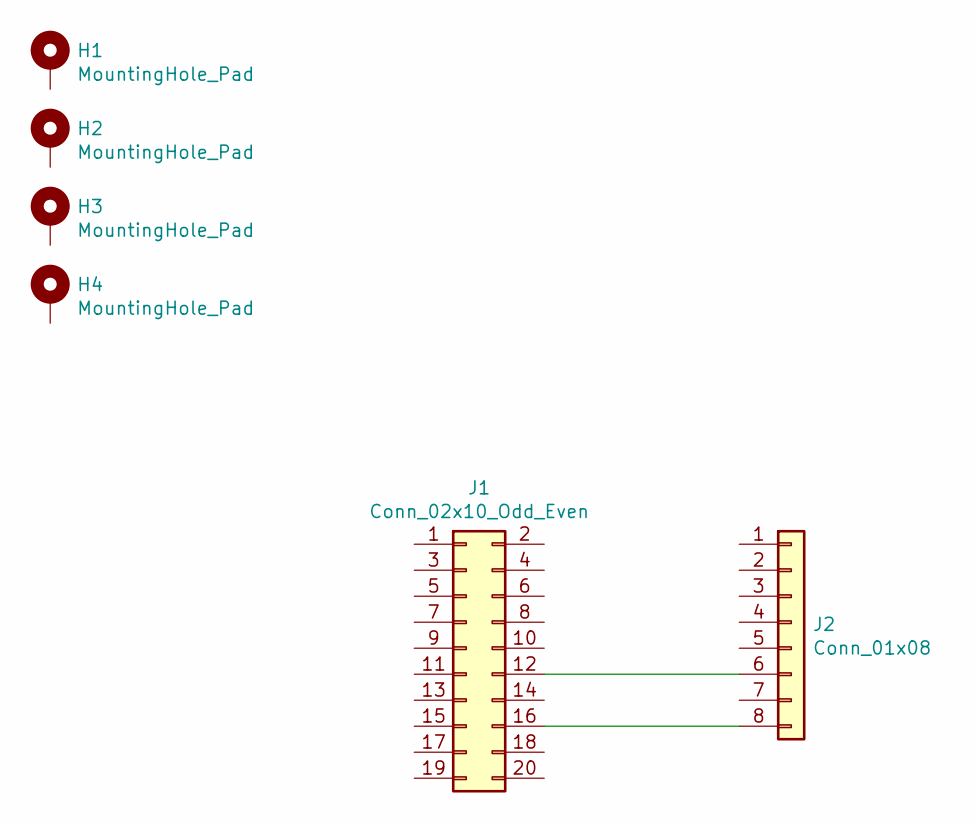
[picture p13: schematic touch-pannel.sch]

Parts:
H1, H2, H3, H4: MountingHole_Pad; MountingHole_3.2mm_M3_Pad_Via
J1: Conn_02x10_Odd_Even; Molex_SlimStack_52991-0208_2x10_P0.50mm_Vertical
J2: Conn_01x08; wheel

Connections:
unnamed: H1.1, H1.~
unnamed: J1.2, J2.1
unnamed: J1.4, J2.2
unnamed: J1.6, J2.3
unnamed: J1.8, J2.4
unnamed: J1.10, J2.5
unnamed: J1.12, J2.6
unnamed: J1.14, J2.7
unnamed: J1.16, J2.8

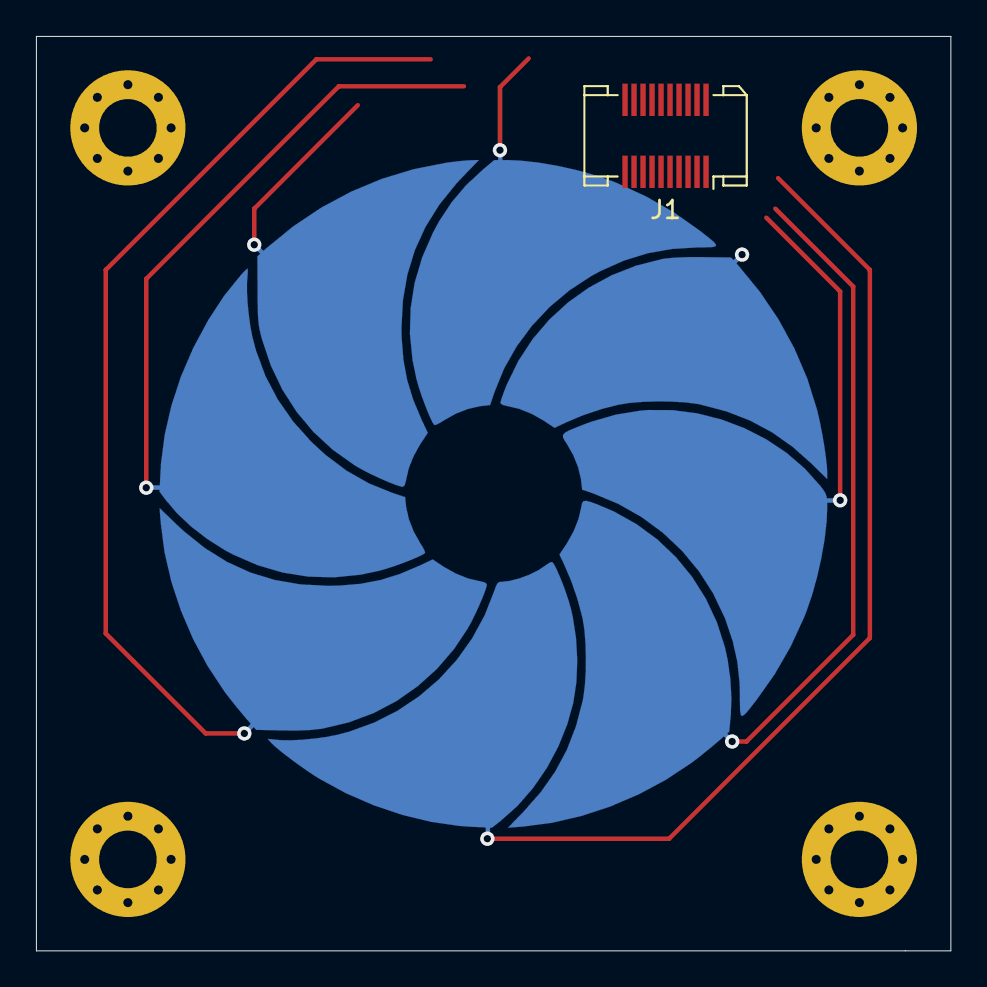
[picture p14: board touch-pannel.kicad_pcb from above]

Board: 2 copper layers, 50.8 x 50.8 mm, 6 parts (1 on the bottom side), 9 nets.
