TorstenRobitzki/DevPort/hardware/led-test/led-test.kicad_pcb

## KiCad design hardware/led-test/led-test.kicad_pcb (2021-03-17)

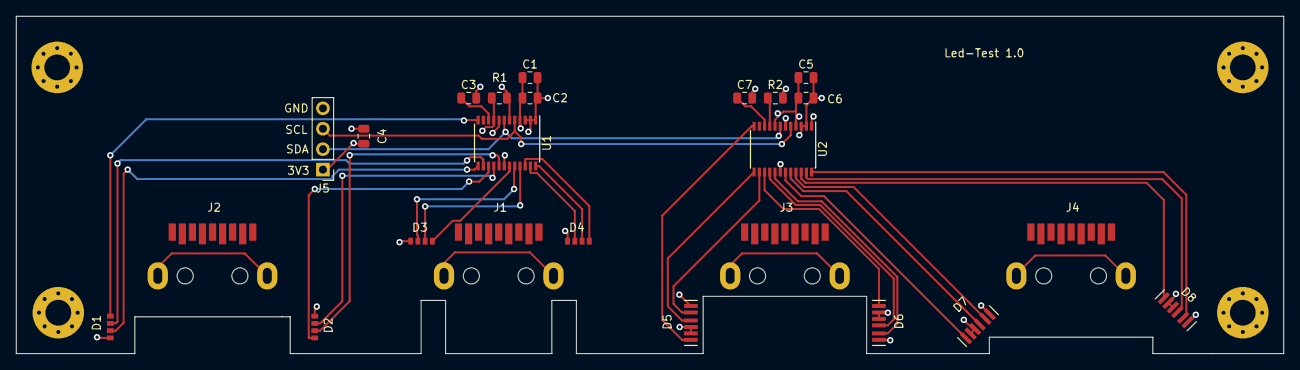
[picture p15: board led-test.kicad_pcb from above]

Board: 4 copper layers, 157.5 x 41.9 mm, 24 parts (0 on the bottom side), 32 nets.

Parts:
C1, C3, C5, C7: 1µF; C_0805_2012Metric
C2, C6: 0.1µF; C_0805_2012Metric
C4: 10µF; C_0805_2012Metric
D1, D2, D3, D4: LED_AGBR; MSL0601RGB
D5, D6, D7, D8: LED_RGB; KRTB_AELPS1.32
J1, J2, J3, J4: USB3_A; WR-COM_USB_3.0_Horizontal_SMT
J5: Conn_01x04_Male; PinHeader_1x04_P2.54mm_Vertical
R1, R2: 3.6k; R_0805_2012Metric
U1, U2: LP5012PWR; TSSOP-24_4.4x7.8mm_P0.65mm

Connections:
+3V3: C1.1, C2.1, C4.1, C5.1, C6.1, D1.1, D2.1, D3.1, D4.1, D5.4, D5.5, D5.6, D6.4, D6.5, D6.6, D7.4, D7.5, D7.6, D8.4, D8.5, D8.6, J5.1, U1.4, U1.8, U2.1, U2.4, U2.8
/SCL: J5.3, U1.5, U2.5
/SDA: J5.2, U1.7, U2.7
GND: C1.2, C2.2, C3.2, C4.2, C5.2, C6.2, C7.2, J5.4, R1.2, R2.2, U1.1, U1.2, U1.3, U1.6, U1.18, U2.2, U2.3, U2.6, U2.18
unnamed: C3.1, U1.10
unnamed: C7.1, U2.10
unnamed: D1.2, U1.13
unnamed: D1.3, U1.14
unnamed: D1.4, U1.12
unnamed: D2.2, U1.16
unnamed: D2.3, U1.17
unnamed: D2.4, U1.15
unnamed: D3.2, U1.20
unnamed: D3.3, U1.21
unnamed: D3.4, U1.19
unnamed: D4.2, U1.23
unnamed: D4.3, U1.24
unnamed: D4.4, U1.22
unnamed: D5.1, U2.12
unnamed: D5.2, U2.13
unnamed: D5.3, U2.14
unnamed: D6.1, U2.15
unnamed: D6.2, U2.16
unnamed: D6.3, U2.17
unnamed: D7.1, U2.19
unnamed: D7.2, U2.20
unnamed: D7.3, U2.21
unnamed: D8.1, U2.22
unnamed: D8.2, U2.23
unnamed: D8.3, U2.24
unnamed: R1.1, U1.9
unnamed: R2.1, U2.9
