TorstenRobitzki/DevPort/hardware/port-plane/port-plane/port-plane.kicad_pcb

## KiCad design hardware/port-plane/port-plane/port-plane.kicad_pcb (2021-03-17)

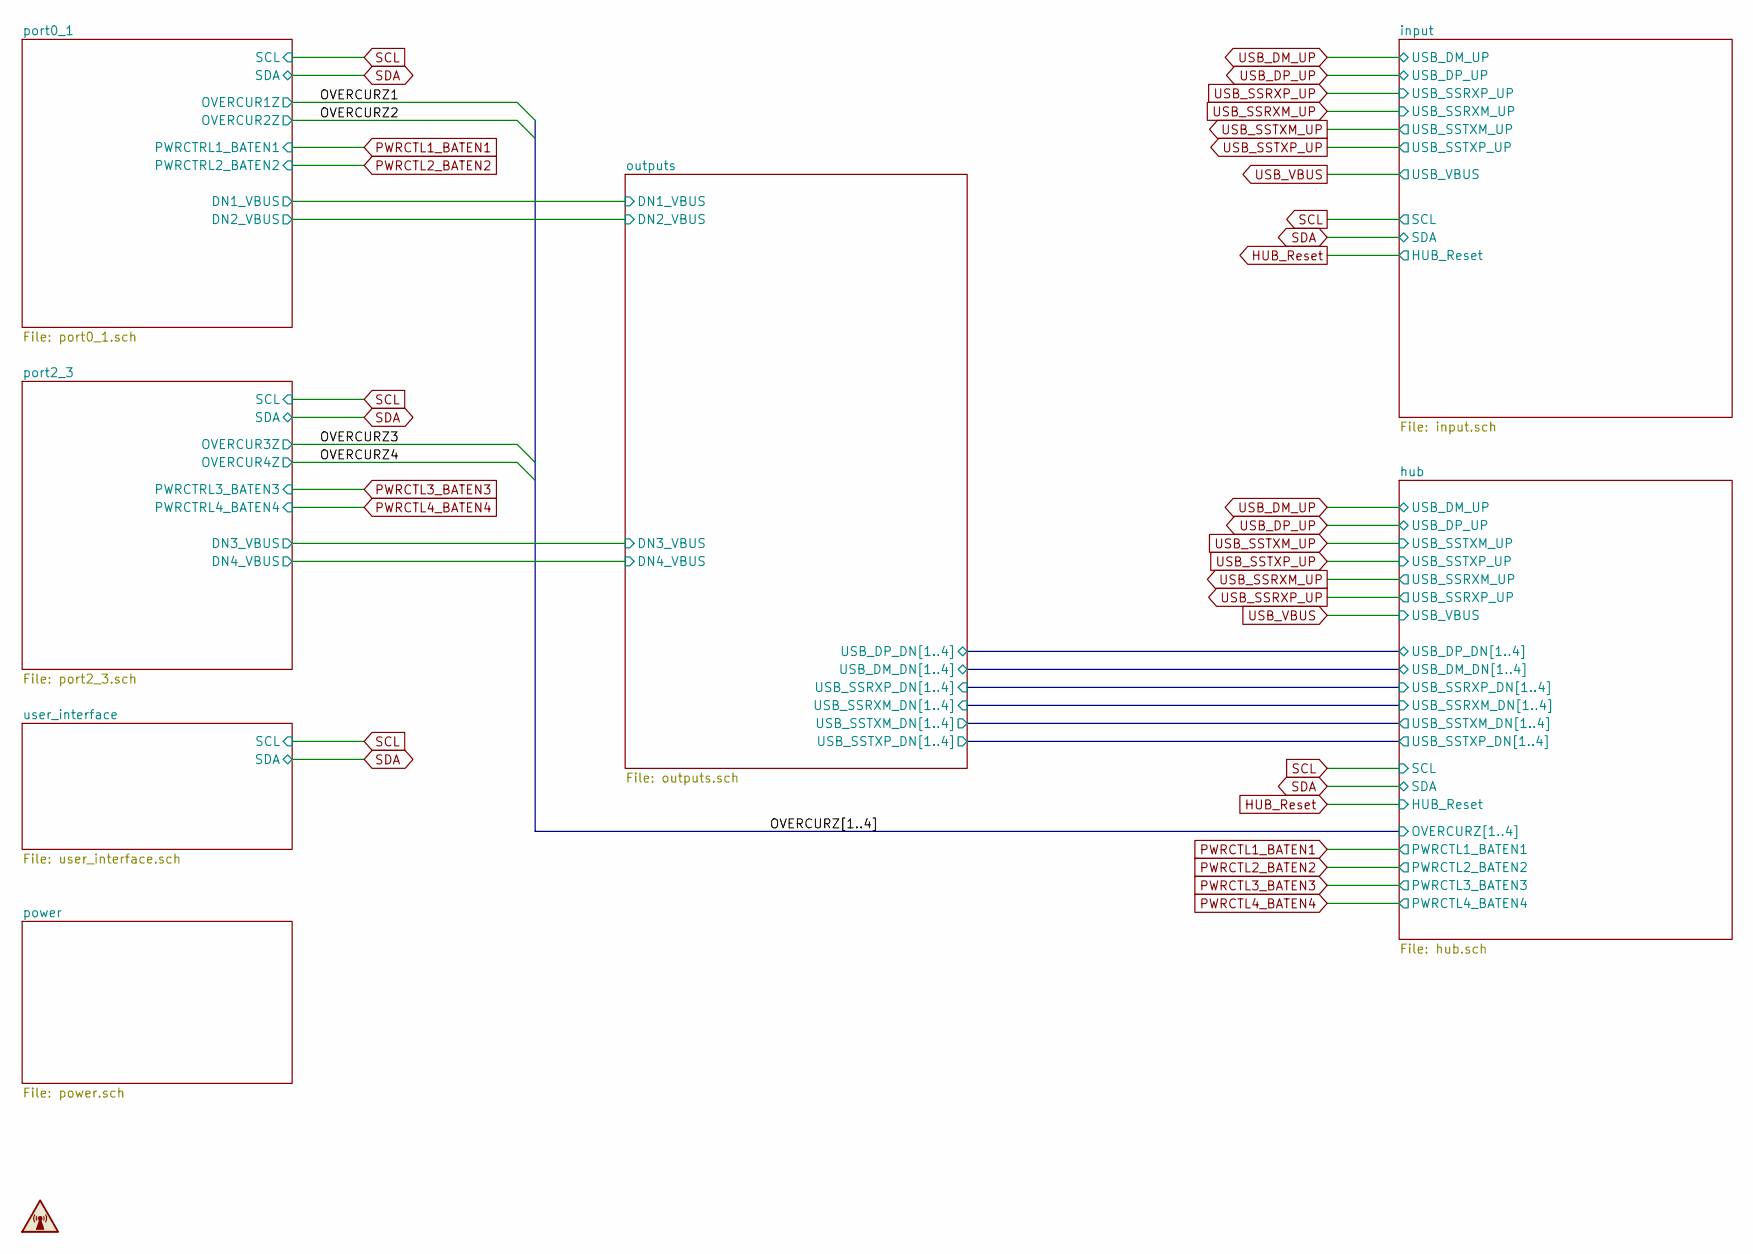
[picture p16: schematic port-plane.sch]

Parts:
SYM1: SYM_Radio_Waves_Small; Torrox_Black

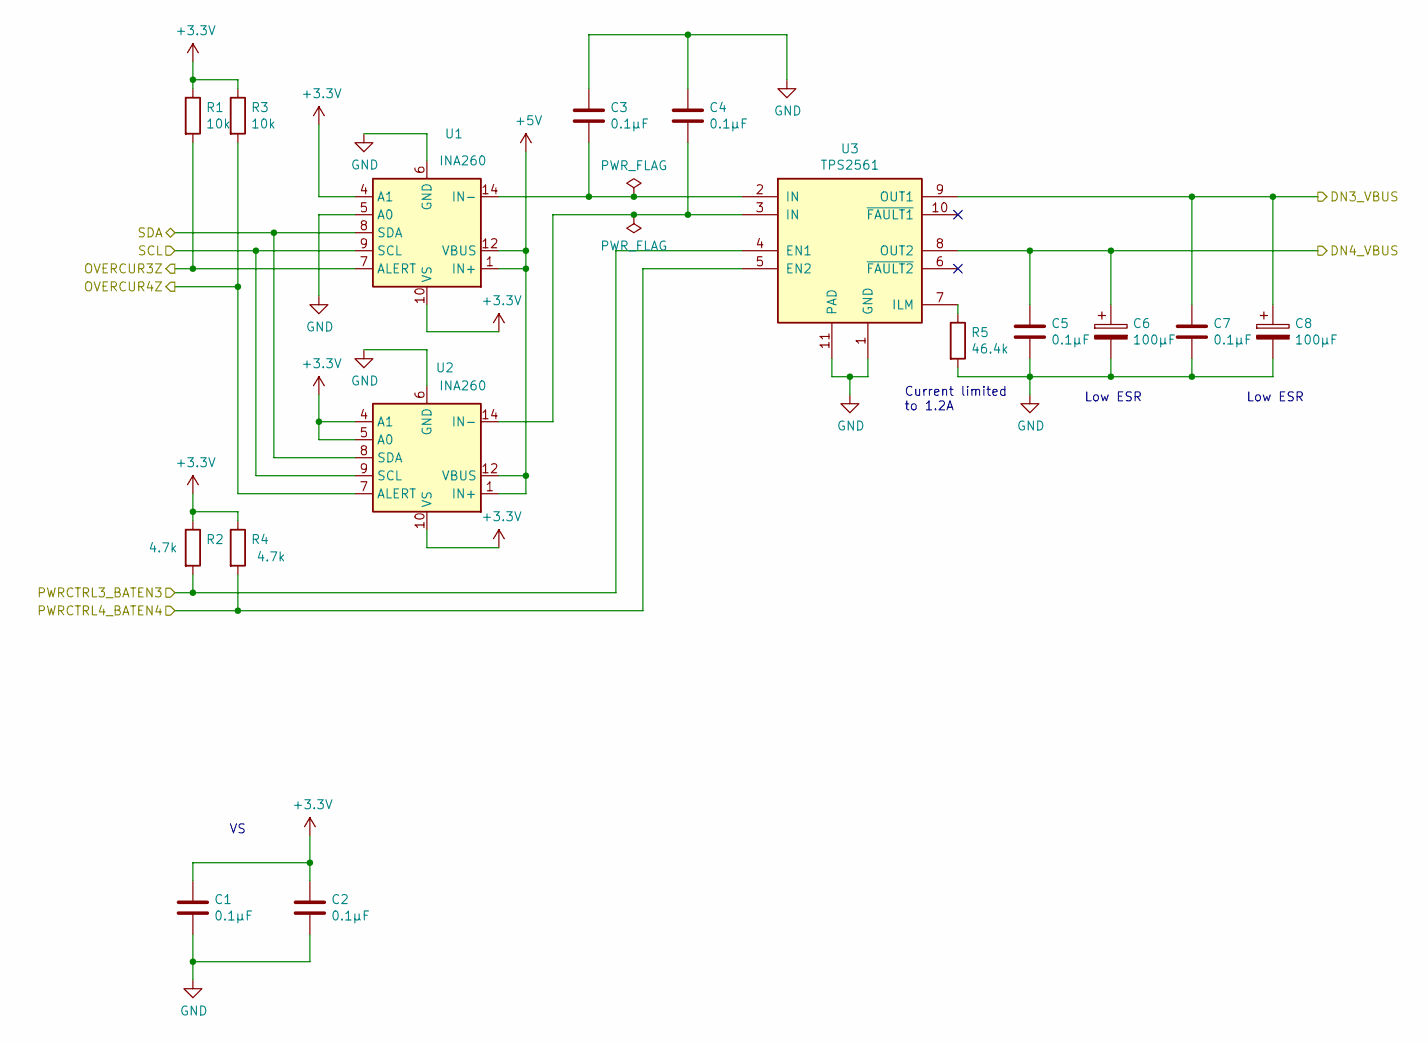
[picture p17: schematic port2_3.sch, Port Plane]

Parts:
C1, C2, C3, C4, C5, C7: 0.1µF; C_0603_1608Metric
C6, C8: 100µF; C_Elec_6.3x7.7
R1, R3: 10k; R_0603_1608Metric
R2, R4: 4.7k; R_0603_1608Metric
R5: 46.4k; R_0603_1608Metric
U1, U2: INA260; TSSOP-16_4.4x5mm_P0.65mm
U3: TPS2561; VSON-10-1EP_3x3mm_P0.5mm_EP1.65x2.4mm_ThermalVias

Connections:
+5V: U1.1 (IN+), U1.2 (IN+), U1.3 (IN+), U1.12 (VBUS), U2.1 (IN+), U2.2 (IN+), U2.3 (IN+), U2.12 (VBUS); also elsewhere on the board
/OVERCURZ3: R1.2, U1.7 (ALERT); also elsewhere on the board
/OVERCURZ4: R3.2, U2.7 (ALERT); also elsewhere on the board
/outputs/DN3_VBUS: C7.1, C8.1, U3.9 (OUT1); also elsewhere on the board
/outputs/DN4_VBUS: C5.1, C6.1, U3.8 (OUT2); also elsewhere on the board
GND: C1.2, C2.2, C3.1, C4.1, C5.2, C6.2, C7.2, C8.2, R5.2, U1.5 (A0), U1.6 (GND), U1.11 (GND), U2.6 (GND), U2.11 (GND), U3.1 (GND), U3.11 (PAD); also elsewhere on the board
unnamed: C3.2, U1.14 (IN-), U1.15 (IN-), U1.16 (IN-), U3.2 (IN)
unnamed: C4.2, U2.14 (IN-), U2.15 (IN-), U2.16 (IN-), U3.3 (IN)
unnamed: R5.1, U3.7 (ILM)
PWRCTL3_BATEN3: R2.2, U3.4 (EN1); also elsewhere on the board
PWRCTL4_BATEN4: R4.2, U3.5 (EN2); also elsewhere on the board

Notes on the sheet:
Current limited to 1.2A
Low ESR

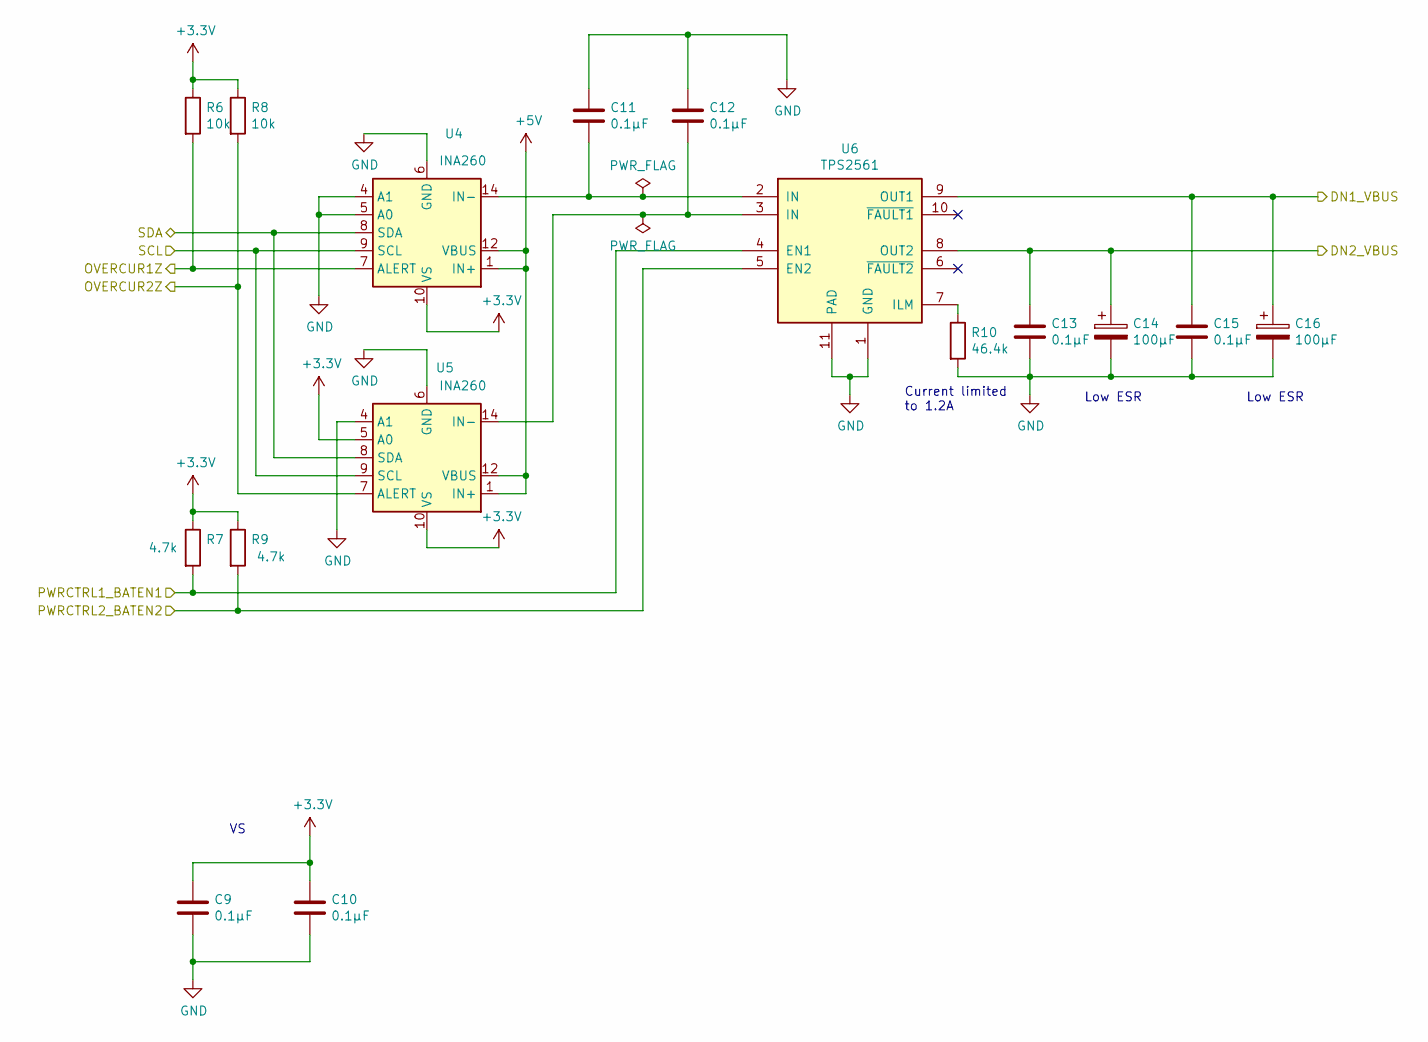
[picture p18: schematic port0_1.sch]

Parts:
C9, C10, C11, C12, C13, C15: 0.1µF; C_0603_1608Metric
C14, C16: 100µF; C_Elec_6.3x7.7
R6, R8: 10k; R_0603_1608Metric
R7, R9: 4.7k; R_0603_1608Metric
R10: 46.4k; R_0603_1608Metric
U4, U5: INA260; TSSOP-16_4.4x5mm_P0.65mm
U6: TPS2561; VSON-10-1EP_3x3mm_P0.5mm_EP1.65x2.4mm_ThermalVias

Connections:
+5V: U4.1 (IN+), U4.2 (IN+), U4.3 (IN+), U4.12 (VBUS), U5.1 (IN+), U5.2 (IN+), U5.3 (IN+), U5.12 (VBUS); also elsewhere on the board
/OVERCURZ1: R6.2, U4.7 (ALERT); also elsewhere on the board
/OVERCURZ2: R8.2, U5.7 (ALERT); also elsewhere on the board
/outputs/DN1_VBUS: C15.1, C16.1, U6.9 (OUT1); also elsewhere on the board
/outputs/DN2_VBUS: C13.1, C14.1, U6.8 (OUT2); also elsewhere on the board
GND: C9.2, C10.2, C11.1, C12.1, C13.2, C14.2, C15.2, C16.2, R10.2, U4.4 (A1), U4.5 (A0), U4.6 (GND), U4.11 (GND), U5.4 (A1), U5.6 (GND), U5.11 (GND), U6.1 (GND), U6.11 (PAD); also elsewhere on the board
unnamed: C11.2, U4.14 (IN-), U4.15 (IN-), U4.16 (IN-), U6.2 (IN)
unnamed: C12.2, U5.14 (IN-), U5.15 (IN-), U5.16 (IN-), U6.3 (IN)
unnamed: R10.1, U6.7 (ILM)
PWRCTL1_BATEN1: R7.2, U6.4 (EN1); also elsewhere on the board
PWRCTL2_BATEN2: R9.2, U6.5 (EN2); also elsewhere on the board

Notes on the sheet:
Current limited to 1.2A
Low ESR

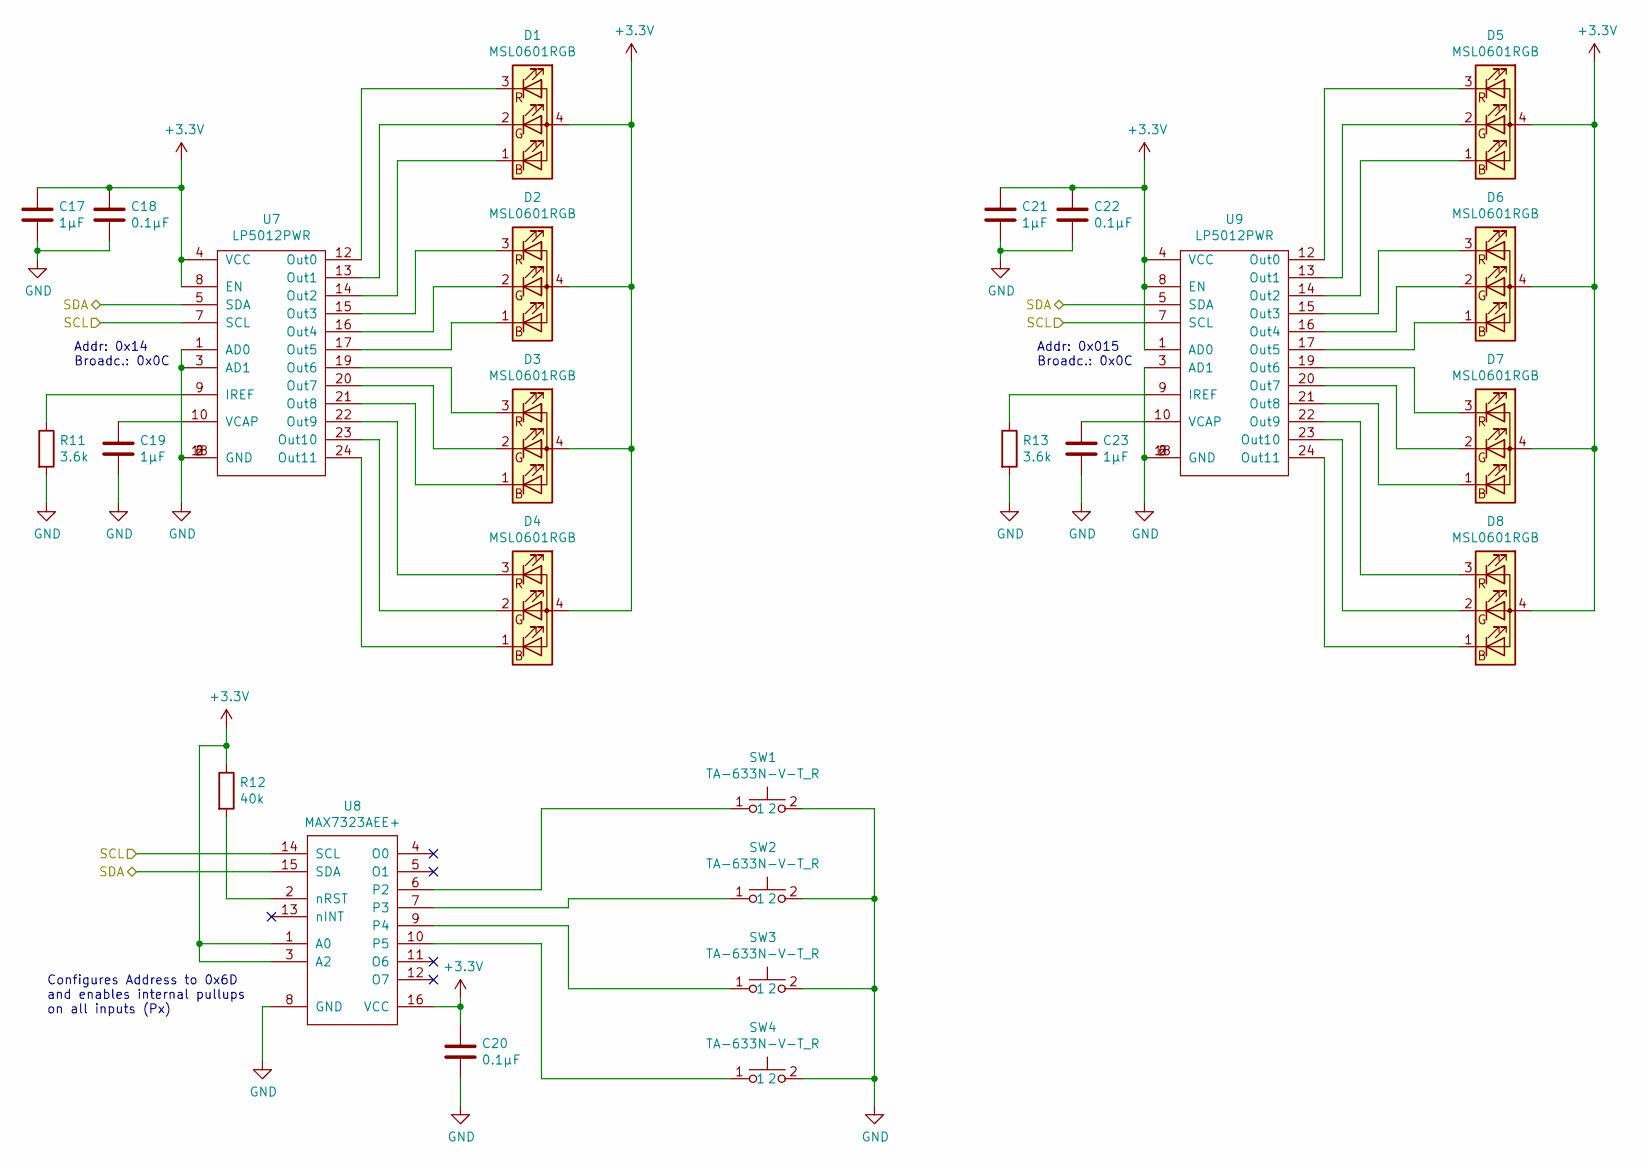
[picture p19: schematic user_interface.sch]

Parts:
C17, C19, C21, C23: 1µF; C_0603_1608Metric
C18, C20, C22: 0.1µF; C_0603_1608Metric
D1, D2, D3, D4, D5, D6, D7, D8: MSL0601RGB
R11, R13: 3.6k; R_0603_1608Metric
R12: 40k; R_0603_1608Metric
SW1, SW2, SW3, SW4: TA-633N-V-T_R; TA-633
U7, U9: LP5012PWR; TSSOP-24_4.4x7.8mm_P0.65mm
U8: MAX7323AEE+; TSSOP-24_4.4x7.8mm_P0.65mm

Connections:
GND: C17.2, C18.2, C19.2, C20.2, C21.2, C22.2, C23.2, R11.2, R13.2, SW1.2, SW2.2, SW3.2, SW4.2, U7.1 (AD0), U7.2 (GND), U7.3 (AD1), U7.6 (GND), U7.18 (GND), U8.8 (GND), U9.2 (GND), U9.3 (AD1), U9.6 (GND), U9.18 (GND); also elsewhere on the board
unnamed: C19.1, U7.10 (VCAP)
unnamed: C23.1, U9.10 (VCAP)
unnamed: D1.1 (BK), U7.14 (Out2)
unnamed: D1.2 (GK), U7.13 (Out1)
unnamed: D1.3 (RK), U7.12 (Out0)
unnamed: D2.1 (BK), U7.17 (Out5)
unnamed: D2.2 (GK), U7.16 (Out4)
unnamed: D2.3 (RK), U7.15 (Out3)
unnamed: D3.1 (BK), U7.21 (Out8)
unnamed: D3.2 (GK), U7.20 (Out7)
unnamed: D3.3 (RK), U7.19 (Out6)
unnamed: D4.1 (BK), U7.24 (Out11)
unnamed: D4.2 (GK), U7.23 (Out10)
unnamed: D4.3 (RK), U7.22 (Out9)
unnamed: D5.1 (BK), U9.14 (Out2)
unnamed: D5.2 (GK), U9.13 (Out1)
unnamed: D5.3 (RK), U9.12 (Out0)
unnamed: D6.1 (BK), U9.17 (Out5)
unnamed: D6.2 (GK), U9.16 (Out4)
unnamed: D6.3 (RK), U9.15 (Out3)
unnamed: D7.1 (BK), U9.21 (Out8)
unnamed: D7.2 (GK), U9.20 (Out7)
unnamed: D7.3 (RK), U9.19 (Out6)
unnamed: D8.1 (BK), U9.24 (Out11)
unnamed: D8.2 (GK), U9.23 (Out10)
unnamed: D8.3 (RK), U9.22 (Out9)
unnamed: R11.1, U7.9 (IREF)
unnamed: R12.2, U8.2 (nRST)
unnamed: R13.1, U9.9 (IREF)
unnamed: SW1.1, U8.6 (P2)
unnamed: SW2.1, U8.7 (P3)
unnamed: SW3.1, U8.9 (P4)
unnamed: SW4.1, U8.10 (P5)

Notes on the sheet:
Configures Address to 0x6D and enables internal pullups on all inputs (Px)
Addr: 0x14 Broadc.: 0x0C
Addr: 0x015 Broadc.: 0x0C

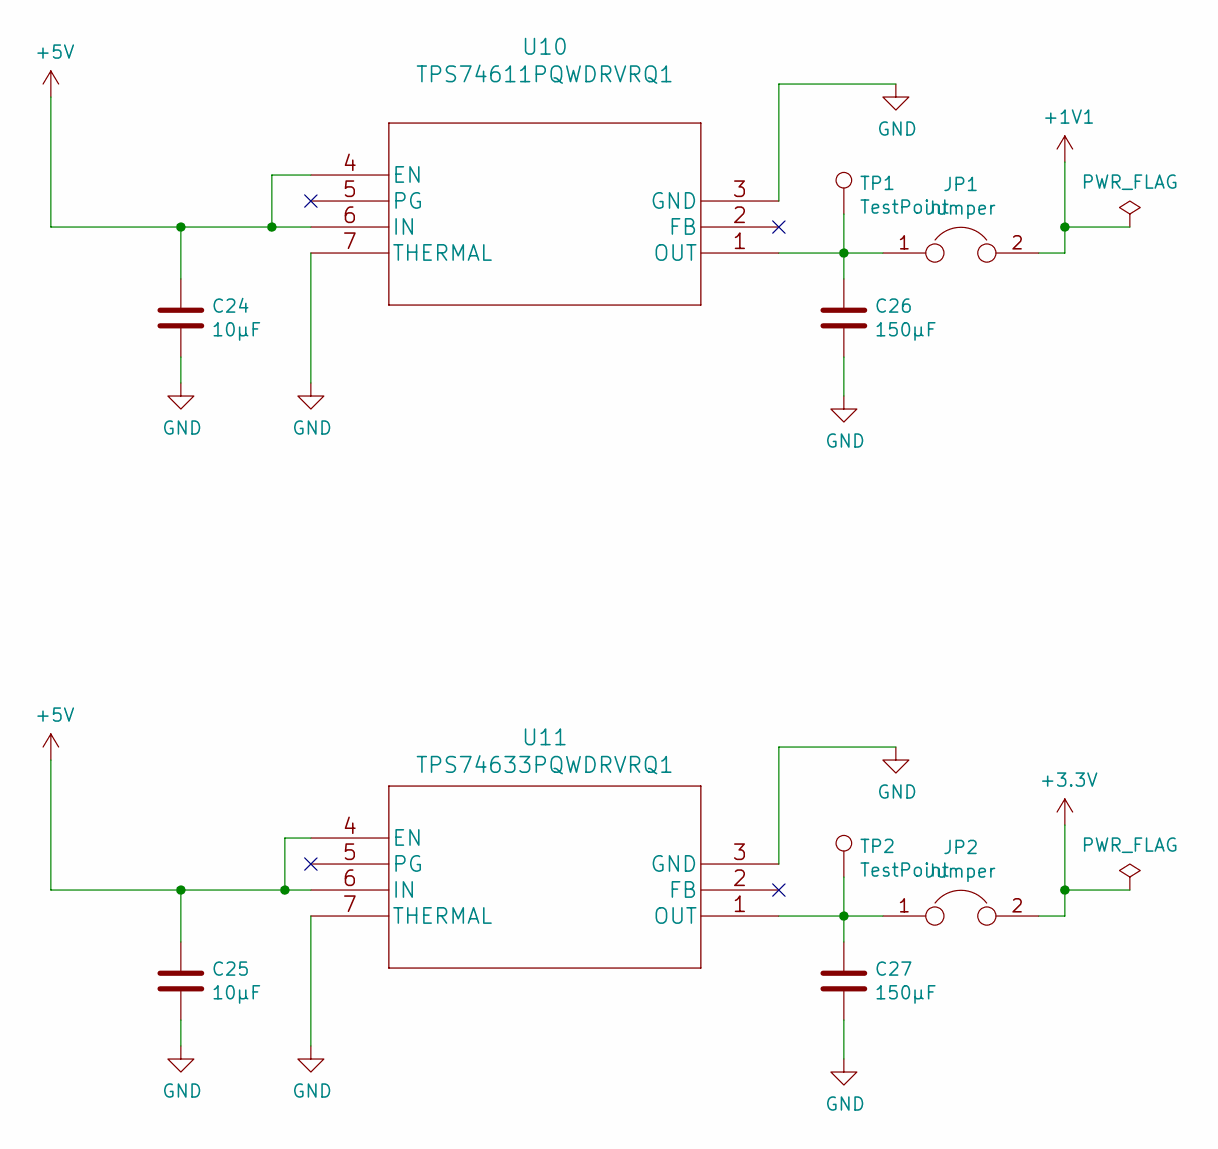
[picture p20: schematic power.sch]

Parts:
C24, C25: 10µF; C_0603_1608Metric
C26, C27: 150µF; C_1210_3225Metric
JP1, JP2: Jumper; SolderJumper-2_P1.3mm_Bridged_RoundedPad1.0x1.5mm
TP1, TP2: TestPoint; TestPoint_THTPad_1.0x1.0mm_Drill0.5mm
U10: TPS74611PQWDRVRQ1; TPS74601PBQWDRVRQ1
U11: TPS74633PQWDRVRQ1; TPS74601PBQWDRVRQ1

Connections:
+1V1: JP1.2; also elsewhere on the board
+5V: C24.1, C25.1, U10.4 (EN), U10.6 (IN), U11.4 (EN), U11.6 (IN); also elsewhere on the board
GND: C24.2, C25.2, C26.2, C27.2, U10.3 (GND), U10.7 (THERMAL), U11.3 (GND), U11.7 (THERMAL); also elsewhere on the board
unnamed: C26.1, JP1.1, TP1.1, U10.1 (OUT)
unnamed: C27.1, JP2.1, TP2.1, U11.1 (OUT)

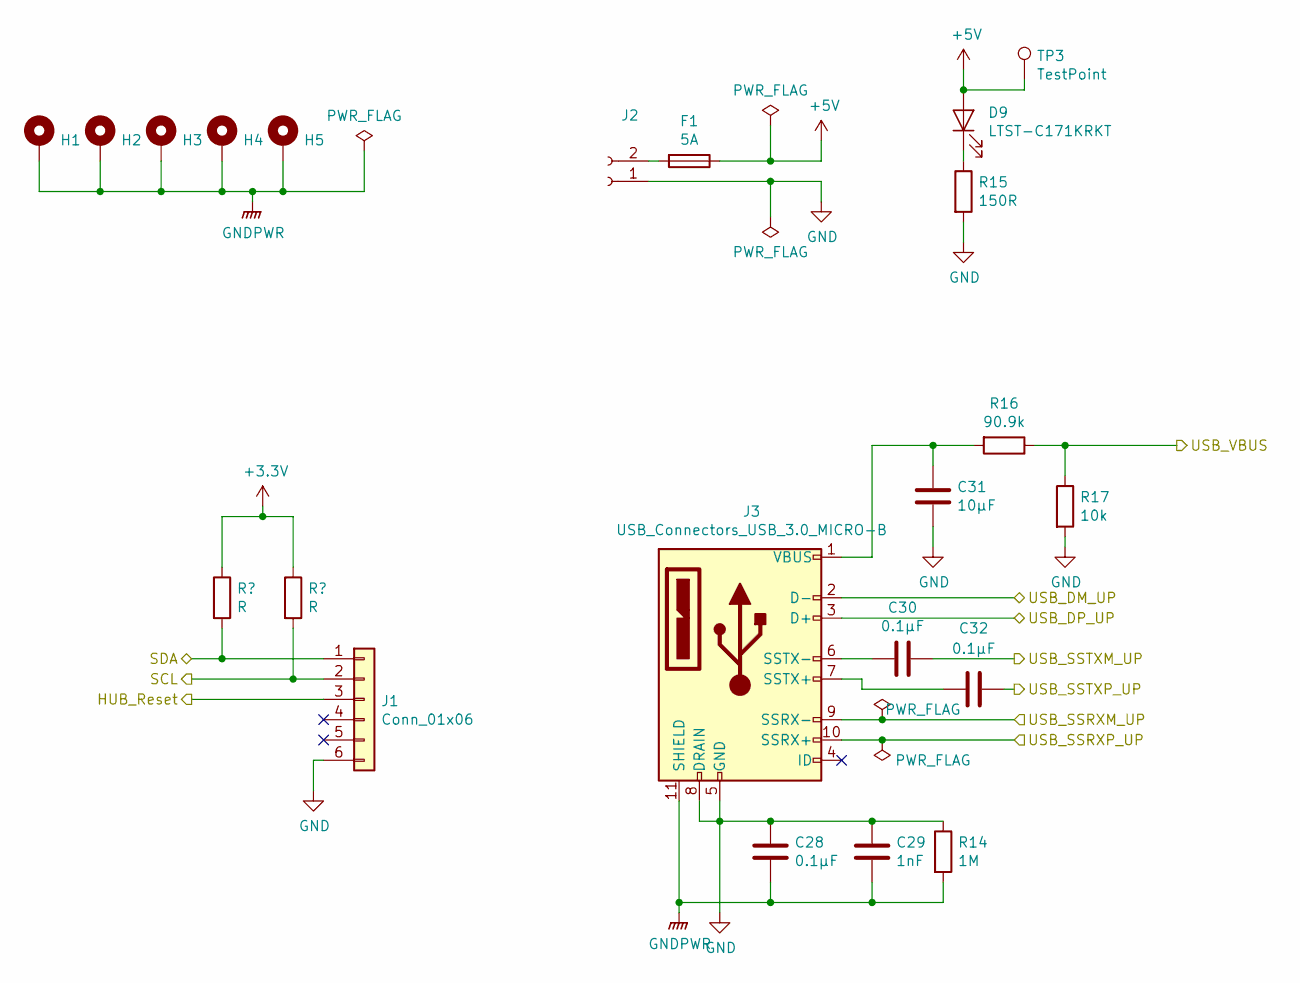
[picture p21: schematic input.sch]

Parts:
C28, C30, C32: 0.1µF; C_0603_1608Metric
C29: 1nF; C_0603_1608Metric
C31: 10µF; C_0603_1608Metric
D9: LTST-C171KRKT; LED_0805_2012Metric
F1: 5A; Fuse_0603_1608Metric_Pad1.05x0.95mm_HandSolder
H1, H2, H3, H4, H5: MountingHole_Pad; MountingHole_3.2mm_M3_Pad_Via
J1: Conn_01x06; PinHeader_2x03_P1.27mm_Vertical_SMD
J2: Conn_01x02_Female; Molex_Mini-Fit_Jr_5566-02A_2x01_P4.20mm_Vertical
J3: USB_Connectors_USB_3.0_MICRO-B; 692622420101
R14: 1M; R_0603_1608Metric
R15: 150R; R_0603_1608Metric
R16: 90.9k; R_0603_1608Metric
R17: 10k; R_0603_1608Metric
TP3: TestPoint; TestPoint_THTPad_1.0x1.0mm_Drill0.5mm

Connections:
+5V: D9.2 (A), F1.1, TP3.1; also elsewhere on the board
GND: C28.1, C29.1, C31.1, J1.6, J2.1, J3.5 (GND), J3.8 (DRAIN), R14.1, R15.2, R17.2; also elsewhere on the board
GNDPWR: C28.2, C29.2, H1.1, H2.1, H3.1, H4.1, H5.1, J3.11 (SHIELD), R14.2; also elsewhere on the board
HUB_Reset: J1.3; also elsewhere on the board
unnamed: C30.2, J3.6 (SSTX-)
unnamed: C31.2, J3.1 (VBUS), R16.2
unnamed: C32.2, J3.7 (SSTX+)
unnamed: D9.1 (K), R15.1
unnamed: F1.2, J2.2
USB_DM_UP: J3.2 (D-); also elsewhere on the board
USB_DP_UP: J3.3 (D+); also elsewhere on the board
USB_SSRXM_UP: J3.9 (SSRX-); also elsewhere on the board
USB_SSRXP_UP: J3.10 (SSRX+); also elsewhere on the board
USB_SSTXM_UP: C30.1; also elsewhere on the board
USB_SSTXP_UP: C32.1; also elsewhere on the board
USB_VBUS: R16.1, R17.1; also elsewhere on the board

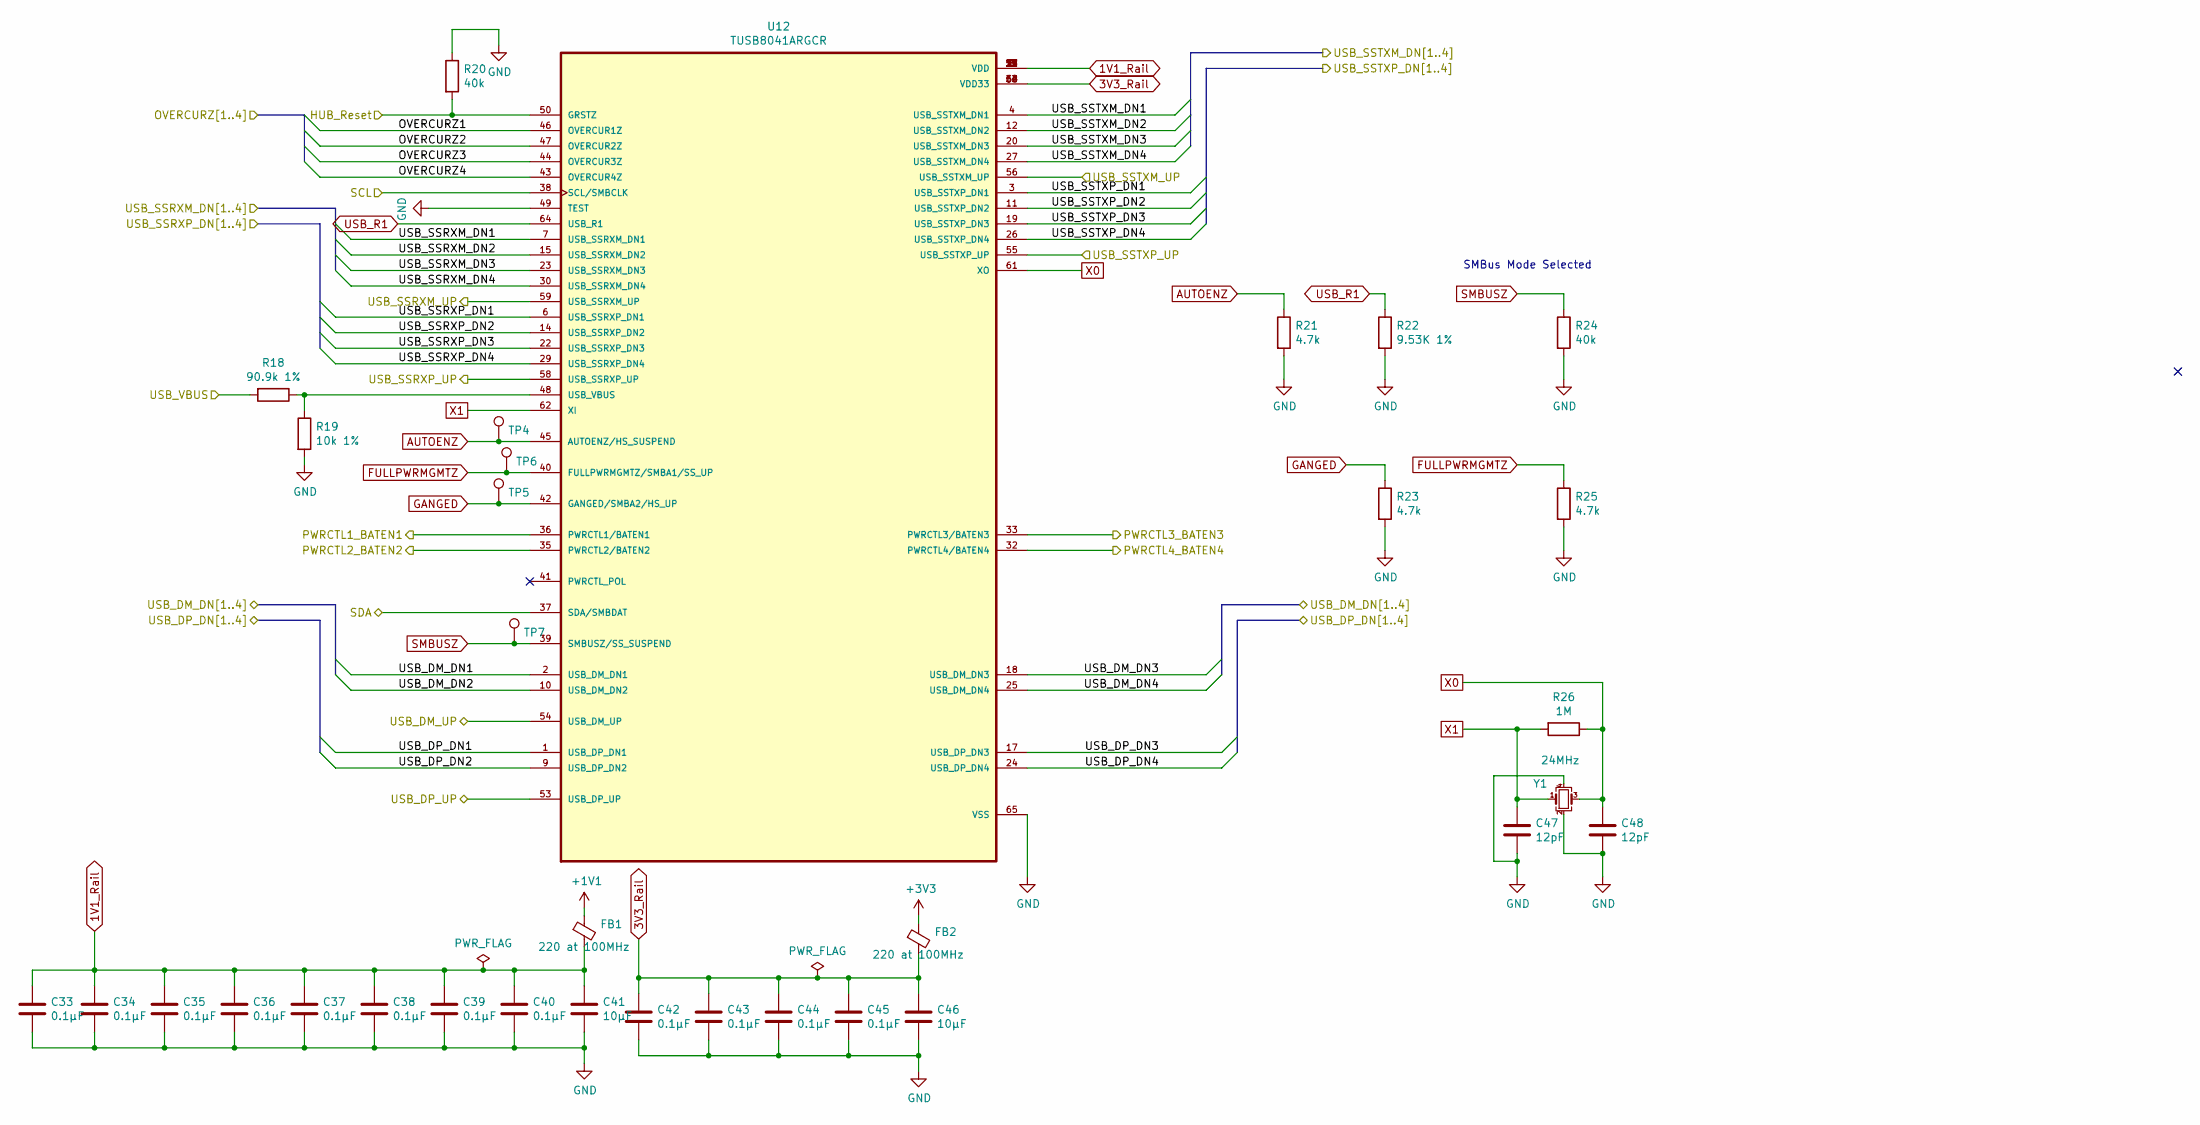
[picture p22: schematic hub.sch]

Parts:
C33, C34, C35, C36, C37, C38, C39, C40, C42, C43, C44, C45: 0.1µF; C_0603_1608Metric
C41, C46: 10µF; C_0603_1608Metric
C47, C48: 12pF; C_0603_1608Metric
FB1, FB2: 220 at 100MHz; L_0603_1608Metric
R18: 90.9k 1%; R_0603_1608Metric
R19: 10k 1%; R_0603_1608Metric
R20, R24: 40k; R_0603_1608Metric
R21, R23, R25: 4.7k; R_0603_1608Metric
R22: 9.53K 1%; R_0603_1608Metric
R26: 1M; R_0603_1608Metric
TP4, TP5, TP6, TP7: TestPoint; TestPoint_THTPad_1.0x1.0mm_Drill0.5mm
U12: TUSB8041ARGCR; QFN50P900X900X100-65N
Y1: 24MHz; Crystal_SMD_3225-4Pin_3.2x2.5mm

Connections:
1V1_Rail: C33.1, C34.1, C35.1, C36.1, C37.1, C38.1, C39.1, C40.1, C41.1, FB1.2, U12.5 (VDD), U12.8 (VDD), U12.13 (VDD), U12.21 (VDD), U12.28 (VDD), U12.31 (VDD), U12.51 (VDD), U12.57 (VDD)
3V3_Rail: C42.1, C43.1, C44.1, C45.1, C46.1, FB2.2, U12.16 (VDD33), U12.34 (VDD33), U12.52 (VDD33), U12.63 (VDD33)
+1V1: FB1.1; also elsewhere on the board
/OVERCURZ1: U12.46 (OVERCUR1Z); also elsewhere on the board
/OVERCURZ2: U12.47 (OVERCUR2Z); also elsewhere on the board
/OVERCURZ3: U12.44 (OVERCUR3Z); also elsewhere on the board
/OVERCURZ4: U12.43 (OVERCUR4Z); also elsewhere on the board
/hub/USB_DM_DN1: U12.2 (USB_DM_DN1); also elsewhere on the board
/hub/USB_DM_DN2: U12.10 (USB_DM_DN2); also elsewhere on the board
/hub/USB_DM_DN3: U12.18 (USB_DM_DN3); also elsewhere on the board
/hub/USB_DM_DN4: U12.25 (USB_DM_DN4); also elsewhere on the board
/hub/USB_DP_DN1: U12.1 (USB_DP_DN1); also elsewhere on the board
/hub/USB_DP_DN2: U12.9 (USB_DP_DN2); also elsewhere on the board
/hub/USB_DP_DN3: U12.17 (USB_DP_DN3); also elsewhere on the board
/hub/USB_DP_DN4: U12.24 (USB_DP_DN4); also elsewhere on the board
/hub/USB_SSRXM_DN1: U12.7 (USB_SSRXM_DN1); also elsewhere on the board
/hub/USB_SSRXM_DN2: U12.15 (USB_SSRXM_DN2); also elsewhere on the board
/hub/USB_SSRXM_DN3: U12.23 (USB_SSRXM_DN3); also elsewhere on the board
/hub/USB_SSRXM_DN4: U12.30 (USB_SSRXM_DN4); also elsewhere on the board
/hub/USB_SSRXP_DN1: U12.6 (USB_SSRXP_DN1); also elsewhere on the board
/hub/USB_SSRXP_DN2: U12.14 (USB_SSRXP_DN2); also elsewhere on the board
/hub/USB_SSRXP_DN3: U12.22 (USB_SSRXP_DN3); also elsewhere on the board
/hub/USB_SSRXP_DN4: U12.29 (USB_SSRXP_DN4); also elsewhere on the board
/hub/USB_SSTXM_DN1: U12.4 (USB_SSTXM_DN1); also elsewhere on the board
/hub/USB_SSTXM_DN2: U12.12 (USB_SSTXM_DN2); also elsewhere on the board
/hub/USB_SSTXM_DN3: U12.20 (USB_SSTXM_DN3); also elsewhere on the board
/hub/USB_SSTXM_DN4: U12.27 (USB_SSTXM_DN4); also elsewhere on the board
/hub/USB_SSTXP_DN1: U12.3 (USB_SSTXP_DN1); also elsewhere on the board
/hub/USB_SSTXP_DN2: U12.11 (USB_SSTXP_DN2); also elsewhere on the board
/hub/USB_SSTXP_DN3: U12.19 (USB_SSTXP_DN3); also elsewhere on the board
/hub/USB_SSTXP_DN4: U12.26 (USB_SSTXP_DN4); also elsewhere on the board
AUTOENZ: R21.1, TP4.1, U12.45 (AUTOENZ/HS_SUSPEND)
FULLPWRMGMTZ: R25.1, TP6.1, U12.40 (FULLPWRMGMTZ/SMBA1/SS_UP)
GANGED: R23.1, TP5.1, U12.42 (GANGED/SMBA2/HS_UP)
GND: C33.2, C34.2, C35.2, C36.2, C37.2, C38.2, C39.2, C40.2, C41.2, C42.2, C43.2, C44.2, C45.2, C46.2, C47.2, C48.2, R19.2, R20.1, R21.2, R22.2, R23.2, R24.2, R25.2, U12.49 (TEST), U12.65 (VSS), Y1.2, Y1.4; also elsewhere on the board
HUB_Reset: R20.2, U12.50 (GRSTZ); also elsewhere on the board
unnamed: R18.1, R19.1, U12.48 (USB_VBUS)
PWRCTL1_BATEN1: U12.36 (PWRCTL1/BATEN1); also elsewhere on the board
PWRCTL2_BATEN2: U12.35 (PWRCTL2/BATEN2); also elsewhere on the board
PWRCTL3_BATEN3: U12.33 (PWRCTL3/BATEN3); also elsewhere on the board
PWRCTL4_BATEN4: U12.32 (PWRCTL4/BATEN4); also elsewhere on the board
SMBUSZ: R24.1, TP7.1, U12.39 (SMBUSZ/SS_SUSPEND)
USB_DM_UP: U12.54 (USB_DM_UP); also elsewhere on the board
USB_DP_UP: U12.53 (USB_DP_UP); also elsewhere on the board
USB_R1: R22.1, U12.64 (USB_R1)
USB_SSRXM_UP: U12.59 (USB_SSRXM_UP); also elsewhere on the board
USB_SSRXP_UP: U12.58 (USB_SSRXP_UP); also elsewhere on the board
USB_SSTXM_UP: U12.56 (USB_SSTXM_UP); also elsewhere on the board
USB_SSTXP_UP: U12.55 (USB_SSTXP_UP); also elsewhere on the board
USB_VBUS: R18.2; also elsewhere on the board
X0: C48.1, R26.1, U12.61 (XO), Y1.3
X1: C47.1, R26.2, U12.62 (XI), Y1.1

Notes on the sheet:
SMBus Mode Selected
