TorstenRobitzki/DevPort/hardware/port-plane/port-plane/port-plane.kicad_pcb

## KiCad design hardware/port-plane/port-plane/port-plane.kicad_pcb (continued)

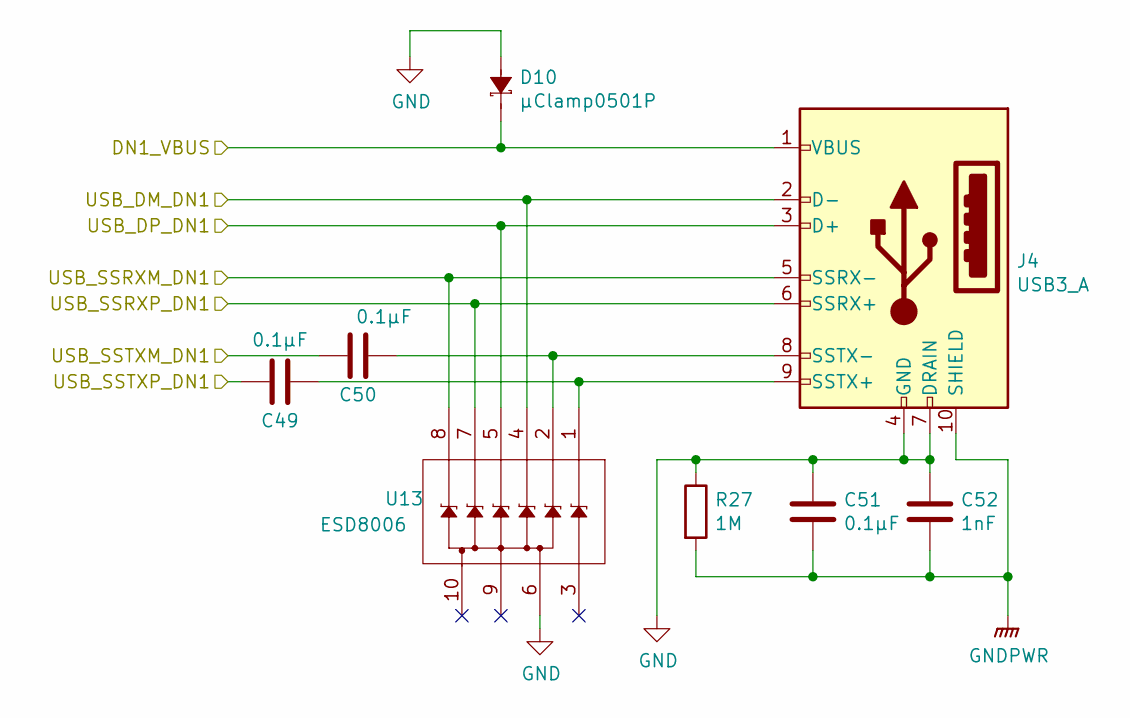
[picture p23: schematic output1.sch]

Parts:
C49, C50: 0.1µF; C_0201_0603Metric
C51: 0.1µF; C_0603_1608Metric
C52: 1nF; C_0603_1608Metric
D10: µClamp0501P; SLP1006P2
J4: USB3_A; WR-COM_USB_3.0_Horizontal_SMT
R27: 1M; R_0603_1608Metric
U13: ESD8006; UDFN8

Connections:
/hub/USB_DM_DN1: J4.2 (D-), U13.4; also elsewhere on the board
/hub/USB_DP_DN1: J4.3 (D+), U13.5; also elsewhere on the board
/hub/USB_SSRXM_DN1: J4.5 (SSRX-), U13.8; also elsewhere on the board
/hub/USB_SSRXP_DN1: J4.6 (SSRX+), U13.7; also elsewhere on the board
/hub/USB_SSTXM_DN1: C50.2; also elsewhere on the board
/hub/USB_SSTXP_DN1: C49.2; also elsewhere on the board
/outputs/DN1_VBUS: D10.2 (K), J4.1 (VBUS); also elsewhere on the board
GND: C51.1, C52.1, D10.1 (A), J4.4 (GND), J4.7 (DRAIN), R27.1, U13.6; also elsewhere on the board
GNDPWR: C51.2, C52.2, J4.10 (SHIELD), R27.2; also elsewhere on the board
unnamed: C49.1, J4.9 (SSTX+), U13.1
unnamed: C50.1, J4.8 (SSTX-), U13.2

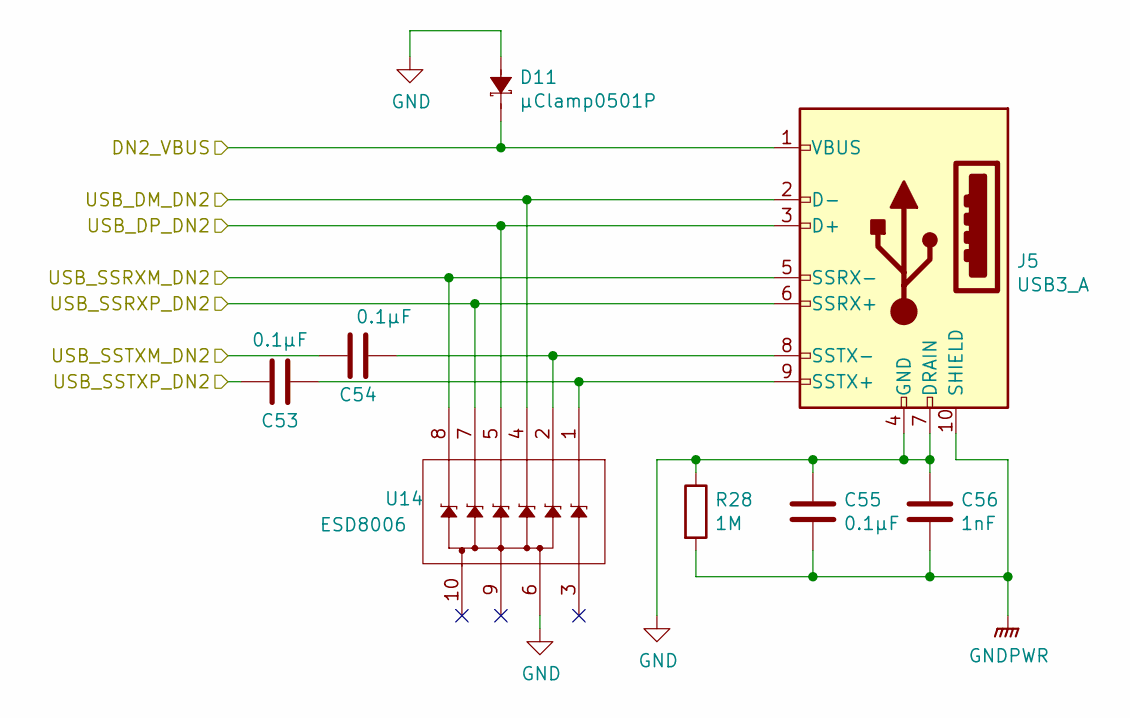
[picture p24: schematic output2.sch]

Parts:
C53, C54: 0.1µF; C_0201_0603Metric
C55: 0.1µF; C_0603_1608Metric
C56: 1nF; C_0603_1608Metric
D11: µClamp0501P; SLP1006P2
J5: USB3_A; WR-COM_USB_3.0_Horizontal_SMT
R28: 1M; R_0603_1608Metric
U14: ESD8006; UDFN8

Connections:
/hub/USB_DM_DN2: J5.2 (D-), U14.4; also elsewhere on the board
/hub/USB_DP_DN2: J5.3 (D+), U14.5; also elsewhere on the board
/hub/USB_SSRXM_DN2: J5.5 (SSRX-), U14.8; also elsewhere on the board
/hub/USB_SSRXP_DN2: J5.6 (SSRX+), U14.7; also elsewhere on the board
/hub/USB_SSTXM_DN2: C54.2; also elsewhere on the board
/hub/USB_SSTXP_DN2: C53.2; also elsewhere on the board
/outputs/DN2_VBUS: D11.2 (K), J5.1 (VBUS); also elsewhere on the board
GND: C55.1, C56.1, D11.1 (A), J5.4 (GND), J5.7 (DRAIN), R28.1, U14.6; also elsewhere on the board
GNDPWR: C55.2, C56.2, J5.10 (SHIELD), R28.2; also elsewhere on the board
unnamed: C53.1, J5.9 (SSTX+), U14.1
unnamed: C54.1, J5.8 (SSTX-), U14.2

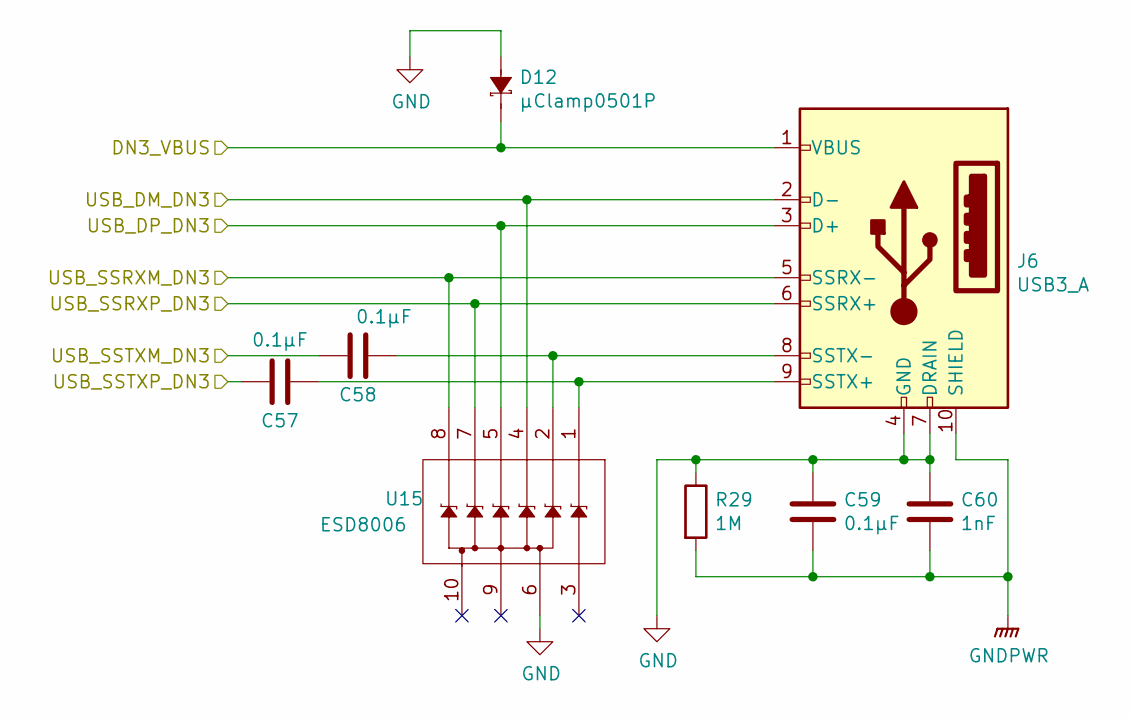
[picture p25: schematic output3.sch]

Parts:
C57, C58: 0.1µF; C_0201_0603Metric
C59: 0.1µF; C_0603_1608Metric
C60: 1nF; C_0603_1608Metric
D12: µClamp0501P; SLP1006P2
J6: USB3_A; WR-COM_USB_3.0_Horizontal_SMT
R29: 1M; R_0603_1608Metric
U15: ESD8006; UDFN8

Connections:
/hub/USB_DM_DN3: J6.2 (D-), U15.4; also elsewhere on the board
/hub/USB_DP_DN3: J6.3 (D+), U15.5; also elsewhere on the board
/hub/USB_SSRXM_DN3: J6.5 (SSRX-), U15.8; also elsewhere on the board
/hub/USB_SSRXP_DN3: J6.6 (SSRX+), U15.7; also elsewhere on the board
/hub/USB_SSTXM_DN3: C58.2; also elsewhere on the board
/hub/USB_SSTXP_DN3: C57.2; also elsewhere on the board
/outputs/DN3_VBUS: D12.2 (K), J6.1 (VBUS); also elsewhere on the board
GND: C59.1, C60.1, D12.1 (A), J6.4 (GND), J6.7 (DRAIN), R29.1, U15.6; also elsewhere on the board
GNDPWR: C59.2, C60.2, J6.10 (SHIELD), R29.2; also elsewhere on the board
unnamed: C57.1, J6.9 (SSTX+), U15.1
unnamed: C58.1, J6.8 (SSTX-), U15.2

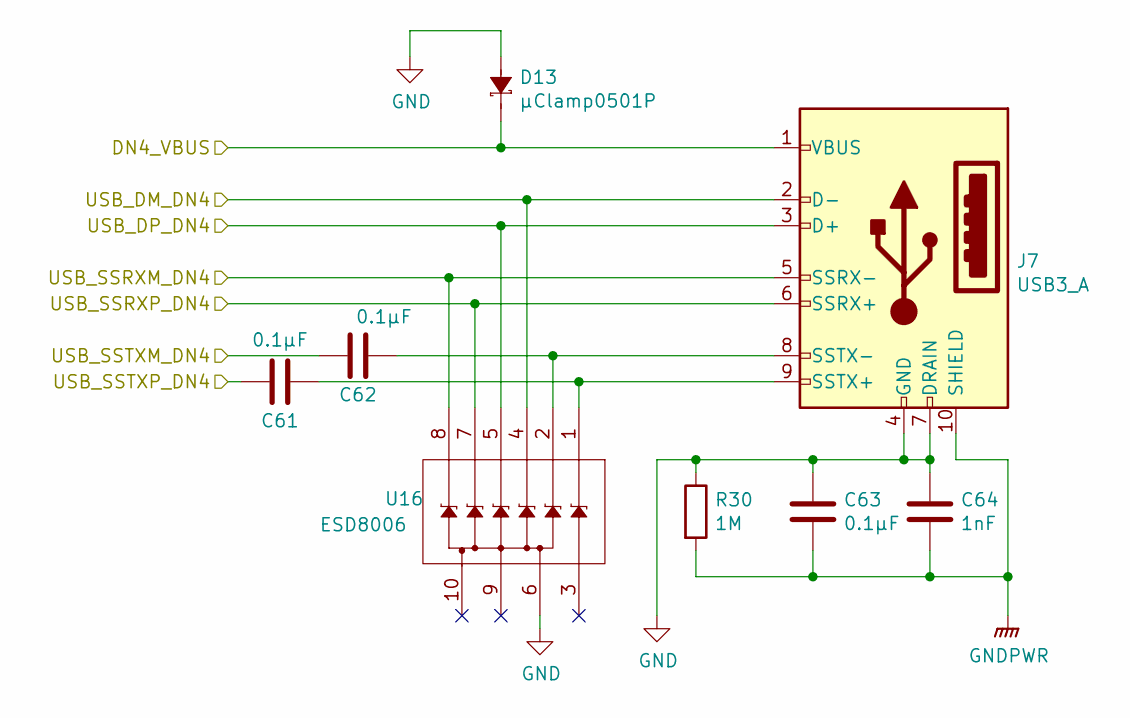
[picture p26: schematic output4.sch]

Parts:
C61, C62: 0.1µF; C_0201_0603Metric
C63: 0.1µF; C_0603_1608Metric
C64: 1nF; C_0603_1608Metric
D13: µClamp0501P; SLP1006P2
J7: USB3_A; WR-COM_USB_3.0_Horizontal_SMT
R30: 1M; R_0603_1608Metric
U16: ESD8006; UDFN8

Connections:
/hub/USB_DM_DN4: J7.2 (D-), U16.4; also elsewhere on the board
/hub/USB_DP_DN4: J7.3 (D+), U16.5; also elsewhere on the board
/hub/USB_SSRXM_DN4: J7.5 (SSRX-), U16.8; also elsewhere on the board
/hub/USB_SSRXP_DN4: J7.6 (SSRX+), U16.7; also elsewhere on the board
/hub/USB_SSTXM_DN4: C62.2; also elsewhere on the board
/hub/USB_SSTXP_DN4: C61.2; also elsewhere on the board
/outputs/DN4_VBUS: D13.2 (K), J7.1 (VBUS); also elsewhere on the board
GND: C63.1, C64.1, D13.1 (A), J7.4 (GND), J7.7 (DRAIN), R30.1, U16.6; also elsewhere on the board
GNDPWR: C63.2, C64.2, J7.10 (SHIELD), R30.2; also elsewhere on the board
unnamed: C61.1, J7.9 (SSTX+), U16.1
unnamed: C62.1, J7.8 (SSTX-), U16.2

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
Board: 2 copper layers, 153 parts (4 on the bottom side), 115 nets, no tracks yet.
