TorstenRobitzki/DevPort/(commit log)

2021-03-11 reading writing i2c
2021-03-17 add hardware
    [On_Semiconductor_-_MCH3478-TL-H.step, TUSB8041RGCR.step, Wurth_Electronics_Inc_-_8240116.step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]
2021-04-08 silkscreen R13; C27 vertauscht
    [base-plane.kicad_pcb]
2021-06-14 move to target hardware without bootloader; 12Mhz external Osc.; LED test
2021-06-16 reading the temperature sensor
2021-06-17 kleinere Anpassungen
    [base-plane.kicad_pcb, controller.sch, hub.sch, input.sch, user_interface.sch]
